B44ken/ria/hardware/oct05-mincaps/README.md

# RIA October 5 PCB candidate

Preserved assistant-authored simplified-capacitor board package, separate from the software PR. Open ria-backplane-mincaps/pcb/ria.kicad_pro in KiCad 10.

Original archive SHA256: dc820657c711623e98abf509f8b5e54f411a94344bfe15b9ce7364861eda980d.
Board SHA256: d4c210754f7143ea50357abc1c7c7ac3fd38924d02991d099fac64ac100dd1eb.

The editable schematic, board, project, libraries, available 3D models, capacitor audit, candidate status and historical DRC/ERC reports were imported from pr #5 at `72f5b655`. That original snapshot remains in git history. The subsequent [review](review-2026-10-14.md) records fresh checks and the XT60 mounting-slot correction; the hashes above identify the original archive and board.

## Limits
Historical KiCad reports describe the imported candidate. Use the review for current saved-file checks and fabrication exports. Firmware, motor-current temperatures and assembly yield remain unverified.
