B44ken/ria/hardware/oct05-mincaps/review-2026-10-14.md

# pcb review, 2026-10-14

reviewed the ss6343m candidate imported from [pr #5](https://github.com/B44ken/ria/pull/5), original head `72f5b655`. backplane now opens this project. the separate sensorless design remains in `pcb/`.

## checks

fresh kicad 10.0.6 erc, refilled drc, schematic parity and the saved-file verifier passed on the imported candidate: 69 components, 59 connected nets, zero violations, opens or exclusions. 142 independent driver pin/net assertions passed. an independent shape audit found 198 routing vias, all with 0.3mm drills and 0.6mm lands, and no via holes intersecting smd copper or paste.

## connector correction

amass's current drawing for c98732 specifies two 0.8×1.9mm mounting slots; the imported footprint used 0.6×1.6mm. the board and local footprint were corrected together, with 1.4×2.5mm copper lands preserving the original 0.3mm annulus. the top edge extends 0.15mm to retain the existing 0.5mm copper-edge clearance. connector position, pin pitch and all electrical nets remain unchanged. after these changes, fresh saved-file erc, refilled drc, parity and the updated verifier again passed with zero violations, opens or exclusions. the driver models now reference the bundled step file instead of a missing temporary path. the xt60 model preview is approximate; fit was checked against the [exact c98732 drawing](https://datasheet.lcsc.com/datasheet/pdf/e258adf1ce44622bb05a5787d35fc0fa.pdf?productCode=C98732). final checks and manufacturing hashes are in `../../build/review/pr5-72f5b65/`.

## pricing

jlcpcb quoted c$11.34 for five bare boards using the corrected 50×69.45mm fabrication files: four layers, 1.6mm thickness, green mask, hasl finish, standard drill class, free solder-mask via plugging and no paid epoxy filling/capping or plating option. this is a fabrication quote, before assembly and shipping; no order or payment was submitted.

the live assembly estimate is c$108.31 before shipping: c$11.34 for five pcbs plus c$96.97 to assemble two on the top side. it includes 68 of 69 placements per assembled board; power-u1, ap63300wu-7/c2158012, is unavailable and excluded. three boards remain bare. this is not a complete assembly quote. the assembly subtotal includes c$38.03 in parts, c$35.05 in extended-part fees and c$23.89 in setup, stencil and assembly services. quoted build time is three days for fabrication plus four to five days for assembly. source files still include the regulator; no substitution was made. [live draft](https://cart.jlcpcb.com/smt-order/?pcbFileNo=b37353e392c94e28b2f8478970549db3), screenshots and fee details are saved with the review artifacts. the driver and imu placement previews align with their footprint pin-one markers.

## qualification

checked the driver pinout and support parts against the [manufacturer v1.2 datasheet](https://www.leadpoweric.com/uploads/admin/file/20230717/f2edd0e2706f078eaf6584854d43b7dc.pdf). no electrical wiring blocker was found. continuous motor-current temperature, braking transients, firmware and assembly yield require bench verification. four encoder buses require a firmware strategy beyond the esp32-s3's two hardware i2c controllers. this board has no phase-current feedback.

final pcb sha256: `78564c2847df0ab76a1cdc7bd88127e3de6a0aa0defd4c1247653595a4438f0f`.
