B44ken/ria/build/review/pr5-72f5b65/drill-report.txt

Drill report for ria.kicad_pcb
Created on 2026-10-14T05:50:54

Copper Layer Stackup:
    =============================================================
    L1 :  F.Cu                      front
    L2 :  In1.Cu                    in1
    L3 :  In2.Cu                    in2
    L4 :  B.Cu                      back

Drill file 'ria-PTH.drl' contains
    plated through holes:
    =============================================================
    T1  0.300mm  0.0118"  (198 holes))
    T2  0.800mm  0.0315"  (4 holes)  (with 4 slots)
    T3  0.800mm  0.0315"  (2 holes)  (with 2 slots)
    T4  1.000mm  0.0394"  (16 holes))
    T5  1.700mm  0.0669"  (6 holes))
    T6  2.900mm  0.1142"  (2 holes))
    T7  4.400mm  0.1732"  (6 holes))

    Total plated holes count 234

Drill file 'ria-NPTH.drl' contains
    unplated through holes:
    =============================================================
    T1  0.600mm  0.0236"  (2 holes))

    Total unplated holes count 2
