B44ken/ria/pcb/.agents/skills/tscircuit/README.md

# tscircuit Agent Skill

This folder is intended to be used as an agent Skill.

Install as:

- `npx skills add tscircuit/skill`

The canonical entrypoint is `SKILL.md`.

## Contents

- `SKILL.md` – Main skill definition (frontmatter + instructions)
- `CLI.md` – tsci CLI command reference
- `SYNTAX.md` – tscircuit JSX syntax primer
- `WORKFLOW.md` – Recommended development workflow
- `BUS_LANES.md` – Fixed-layer bus phases, fanout handoffs, and length matching
- `CHECKLIST.md` – Pre-export/pre-fab checklist

## License

See `LICENSE` for terms.
