B44ken/ria/.playwright-mcp/page-2026-10-28T21-33-26-059Z.png

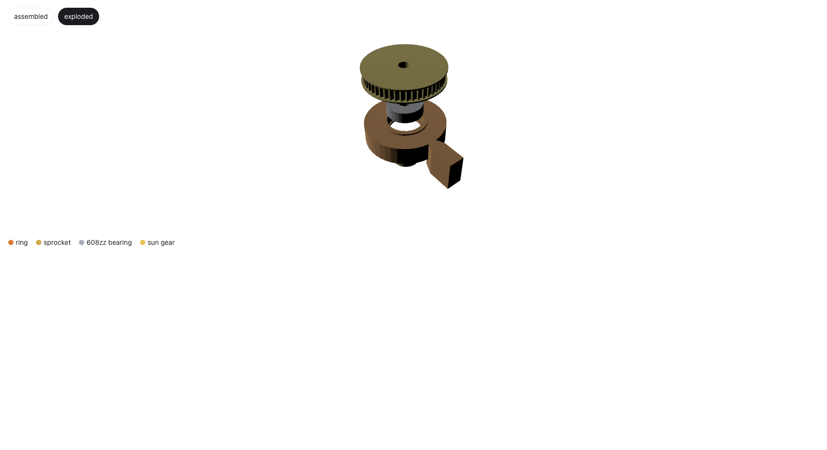
.playwright-mcp/page-2026-10-28T21-33-26-059Z.png
