B44ken/ria/.playwright-mcp/page-2026-10-28T21-34-46-661Z.png

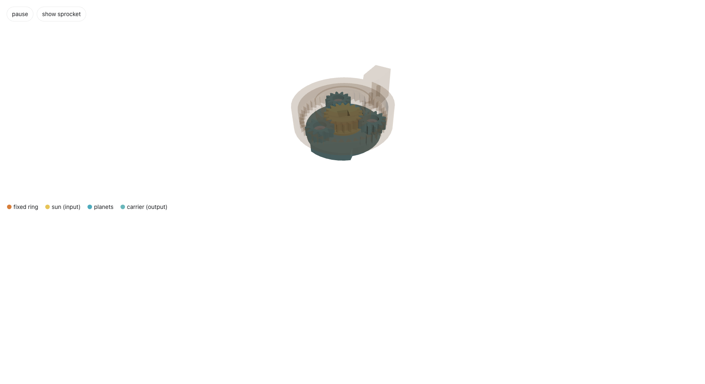
.playwright-mcp/page-2026-10-28T21-34-46-661Z.png
