B44ken/ria/.playwright-mcp/page-2026-10-28T21-44-37-201Z.png

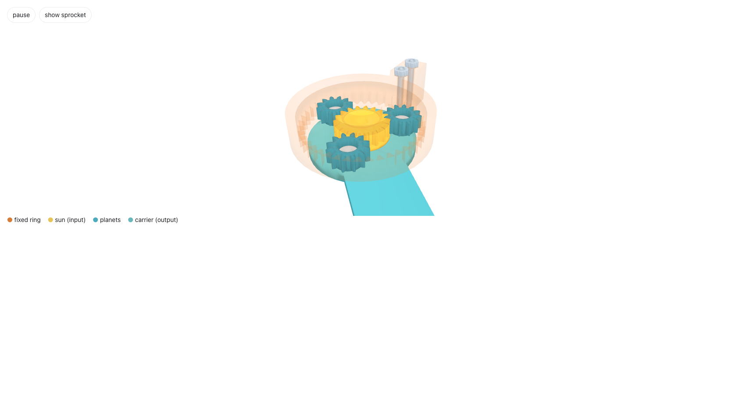
.playwright-mcp/page-2026-10-28T21-44-37-201Z.png
