B44ken/ria/.playwright-mcp/page-2026-10-28T21-49-19-035Z.png

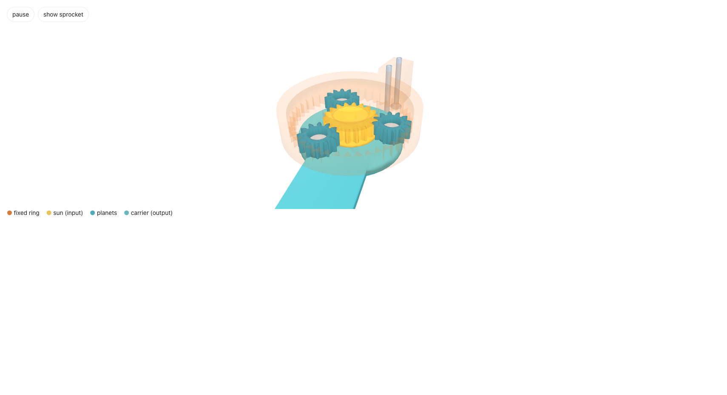
.playwright-mcp/page-2026-10-28T21-49-19-035Z.png
