B44ken/ria/build/pcb-review/schematic.png

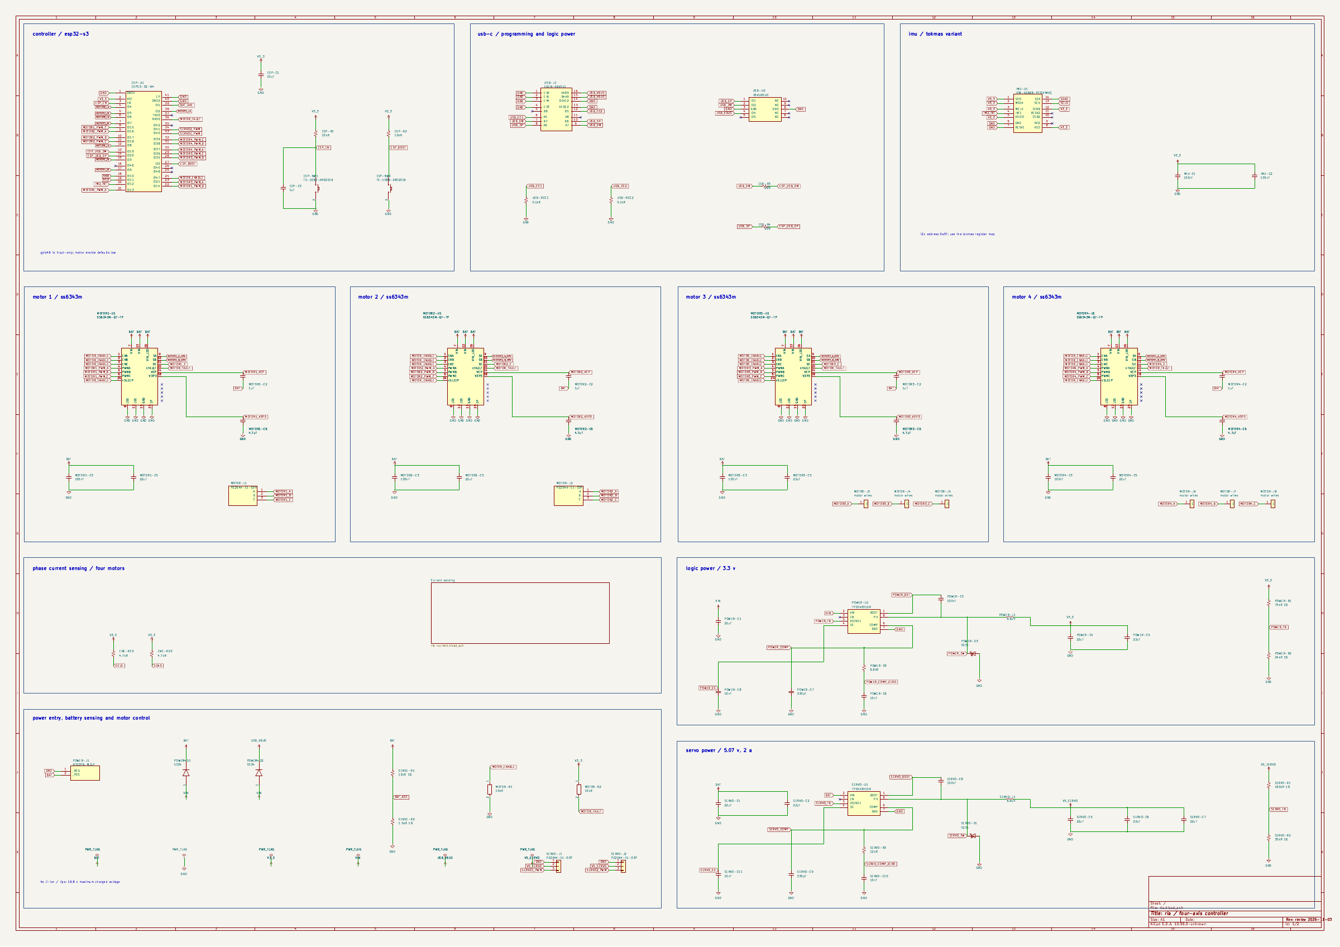
build/pcb-review/schematic.png
