B44ken/ria/build/pcb-review/bom.csv

Comment | Designator | Footprint | LCSC Part # | MPN | Manufacturer
4.7kR | ENC-RC0 | ria:ENC-RC0 | C23162 | 0603WAF4701T5E | UNI-ROYAL(Uniroyal Elec)
4.7kR | ENC-RD0 | ria:ENC-RD0 | C23162 | 0603WAF4701T5E | UNI-ROYAL(Uniroyal Elec)
10uF | ESP-C1 | ria:ESP-C1 | C15850 | CL21A106KAYNNNE | Samsung Electro-Mechanics
1uF | ESP-C3 | ria:C_0805_2012Metric | C28323 | CL21B105KBFNNNE | Samsung Electro-Mechanics
10kR | ESP-R1 | ria:ESP-R1 | C25804 | 0603WAF1002T5E | UNI-ROYAL(Uniroyal Elec)
10kR | ESP-R2 | ria:ESP-R2 | C25804 | 0603WAF1002T5E | UNI-ROYAL(Uniroyal Elec)
22R | ESP-R3 | ria:ESP-R3 | C23345 | 0603WAF220JT5E | UNI-ROYAL(Uniroyal Elec)
22R | ESP-R4 | ria:ESP-R4 | C23345 | 0603WAF220JT5E | UNI-ROYAL(Uniroyal Elec)
TS-1088-AR02016 | ESP-SW1 | ria:ESP-SW1 | C720477 | TS-1088-AR02016 | XUNPU
TS-1088-AR02016 | ESP-SW2 | ria:ESP-SW2 | C720477 | TS-1088-AR02016 | XUNPU
ESPS3-32-N4 | ESP-U1 | ria:ESP-U1 | C49164655 | ESPS3-32-N4 | DOIT
100nF | IMU-C1 | ria:IMU-C1 | C14663 | CC0603KRX7R9BB104 | YAGEO
100nF | IMU-C2 | ria:IMU-C2 | C14663 | CC0603KRX7R9BB104 | YAGEO
ICM-42688-P(TOKMAS) | IMU-U1 | ria:IMU-U1 | C54308212 | ICM-42688-P(TOKMAS) | Tokmas
PZ254V-11-03P | MOTOR-J1 | ria:MOTOR-J1 | C2937625 | PZ254V-11-03P | XFCN
PZ254V-11-03P | MOTOR-J2 | ria:MOTOR-J2 | C2937625 | PZ254V-11-03P | XFCN
10kR | MOTOR-R1 | ria:MOTOR-RE | C25804 | 0603WAF1002T5E | UNI-ROYAL(Uniroyal Elec)
10kR | MOTOR-R2 | ria:MOTOR-RS | C25804 | 0603WAF1002T5E | UNI-ROYAL(Uniroyal Elec)
1uF | MOTOR1-C2 | ria:C_0805_2012Metric | C28323 | CL21B105KBFNNNE | Samsung Electro-Mechanics
100nF | MOTOR1-C3 | ria:MOTOR1-C3 | C14663 | CC0603KRX7R9BB104 | YAGEO
22uF | MOTOR1-C5 | ria:C_1206_3216Metric | C12891 | CL31A226KAHNNNE | Samsung Electro-Mechanics
4.7uF | MOTOR1-C6 | ria:MOTOR1-C6 | C19666 | CL10A475KO8NNNC | Samsung Electro-Mechanics
100nF | MOTOR1-CC1 | ria:C_0603_CURRENT | C14663 | CC0603KRX7R9BB104 | YAGEO
100nF | MOTOR1-CC2 | ria:C_0603_CURRENT | C14663 | CC0603KRX7R9BB104 | YAGEO
INA241A3IDDFR | MOTOR1-CS1 | ria:INA241A3_DDF | C6051860 | INA241A3IDDFR | Texas Instruments
INA241A3IDDFR | MOTOR1-CS2 | ria:INA241A3_DDF | C6051860 | INA241A3IDDFR | Texas Instruments
10mOhm 1% 1W | MOTOR1-RS1 | ria:SHUNT_1206_KELVIN | C2692042 | SMR12M1FR010T | SART
10mOhm 1% 1W | MOTOR1-RS2 | ria:SHUNT_1206_KELVIN | C2692042 | SMR12M1FR010T | SART
SS6343M-QF-TP | MOTOR1-U1 | ria:SS6343M-QF-TP | C5370899 | SS6343M-QF-TP | LEADPOWER
1uF | MOTOR2-C2 | ria:C_0805_2012Metric | C28323 | CL21B105KBFNNNE | Samsung Electro-Mechanics
100nF | MOTOR2-C3 | ria:MOTOR2-C3 | C14663 | CC0603KRX7R9BB104 | YAGEO
22uF | MOTOR2-C5 | ria:C_1206_3216Metric | C12891 | CL31A226KAHNNNE | Samsung Electro-Mechanics
4.7uF | MOTOR2-C6 | ria:MOTOR2-C6 | C19666 | CL10A475KO8NNNC | Samsung Electro-Mechanics
100nF | MOTOR2-CC1 | ria:C_0603_CURRENT | C14663 | CC0603KRX7R9BB104 | YAGEO
100nF | MOTOR2-CC2 | ria:C_0603_CURRENT | C14663 | CC0603KRX7R9BB104 | YAGEO
INA241A3IDDFR | MOTOR2-CS1 | ria:INA241A3_DDF | C6051860 | INA241A3IDDFR | Texas Instruments
INA241A3IDDFR | MOTOR2-CS2 | ria:INA241A3_DDF | C6051860 | INA241A3IDDFR | Texas Instruments
10mOhm 1% 1W | MOTOR2-RS1 | ria:SHUNT_1206_KELVIN | C2692042 | SMR12M1FR010T | SART
10mOhm 1% 1W | MOTOR2-RS2 | ria:SHUNT_1206_KELVIN | C2692042 | SMR12M1FR010T | SART
SS6343M-QF-TP | MOTOR2-U1 | ria:SS6343M-QF-TP | C5370899 | SS6343M-QF-TP | LEADPOWER
1uF | MOTOR3-C2 | ria:C_0805_2012Metric | C28323 | CL21B105KBFNNNE | Samsung Electro-Mechanics
100nF | MOTOR3-C3 | ria:MOTOR3-C3 | C14663 | CC0603KRX7R9BB104 | YAGEO
22uF | MOTOR3-C5 | ria:C_1206_3216Metric | C12891 | CL31A226KAHNNNE | Samsung Electro-Mechanics
4.7uF | MOTOR3-C6 | ria:MOTOR3-C6 | C19666 | CL10A475KO8NNNC | Samsung Electro-Mechanics
100nF | MOTOR3-CC1 | ria:C_0603_CURRENT | C14663 | CC0603KRX7R9BB104 | YAGEO
100nF | MOTOR3-CC2 | ria:C_0603_CURRENT | C14663 | CC0603KRX7R9BB104 | YAGEO
INA241A3IDDFR | MOTOR3-CS1 | ria:INA241A3_DDF | C6051860 | INA241A3IDDFR | Texas Instruments
INA241A3IDDFR | MOTOR3-CS2 | ria:INA241A3_DDF | C6051860 | INA241A3IDDFR | Texas Instruments
10mOhm 1% 1W | MOTOR3-RS1 | ria:SHUNT_1206_KELVIN | C2692042 | SMR12M1FR010T | SART
10mOhm 1% 1W | MOTOR3-RS2 | ria:SHUNT_1206_KELVIN | C2692042 | SMR12M1FR010T | SART
SS6343M-QF-TP | MOTOR3-U1 | ria:SS6343M-QF-TP | C5370899 | SS6343M-QF-TP | LEADPOWER
1uF | MOTOR4-C2 | ria:C_0805_2012Metric | C28323 | CL21B105KBFNNNE | Samsung Electro-Mechanics
100nF | MOTOR4-C3 | ria:MOTOR4-C3 | C14663 | CC0603KRX7R9BB104 | YAGEO
22uF | MOTOR4-C5 | ria:C_1206_3216Metric | C12891 | CL31A226KAHNNNE | Samsung Electro-Mechanics
4.7uF | MOTOR4-C6 | ria:MOTOR4-C6 | C19666 | CL10A475KO8NNNC | Samsung Electro-Mechanics
100nF | MOTOR4-CC1 | ria:C_0603_CURRENT | C14663 | CC0603KRX7R9BB104 | YAGEO
100nF | MOTOR4-CC2 | ria:C_0603_CURRENT | C14663 | CC0603KRX7R9BB104 | YAGEO
INA241A3IDDFR | MOTOR4-CS1 | ria:INA241A3_DDF | C6051860 | INA241A3IDDFR | Texas Instruments
INA241A3IDDFR | MOTOR4-CS2 | ria:INA241A3_DDF | C6051860 | INA241A3IDDFR | Texas Instruments
10mOhm 1% 1W | MOTOR4-RS1 | ria:SHUNT_1206_KELVIN | C2692042 | SMR12M1FR010T | SART
10mOhm 1% 1W | MOTOR4-RS2 | ria:SHUNT_1206_KELVIN | C2692042 | SMR12M1FR010T | SART
SS6343M-QF-TP | MOTOR4-U1 | ria:SS6343M-QF-TP | C5370899 | SS6343M-QF-TP | LEADPOWER
22uF | POWER-C1 | ria:POWER-C1 | C12891 | CL31A226KAHNNNE | Samsung Electro-Mechanics
100nF | POWER-C3 | ria:POWER-C3 | C14663 | CC0603KRX7R9BB104 | YAGEO
22uF | POWER-C4 | ria:POWER-C4 | C12891 | CL31A226KAHNNNE | Samsung Electro-Mechanics
22uF | POWER-C5 | ria:POWER-C5 | C12891 | CL31A226KAHNNNE | Samsung Electro-Mechanics
10nF | POWER-C6 | ria:POWER-C6 | C57112 | 0603B103K500NT | FH (Guangdong Fenghua Advanced Tech)
330pF | POWER-C7 | ria:POWER-C7 | C1664 | CL10C331JB8NNNC | Samsung Electro-Mechanics
10nF | POWER-C8 | ria:POWER-C8 | C57112 | 0603B103K500NT | FH (Guangdong Fenghua Advanced Tech)
SS34 | POWER-D1 | ria:POWER-D1 | C8678 | SS34 | MDD(Microdiode Semiconductor)
SS34 | POWER-D2 | ria:POWER-D2 | C8678 | SS34 | MDD(Microdiode Semiconductor)
SS34 | POWER-D3 | ria:POWER-D3 | C8678 | SS34 | MDD
XT60PB-M.G.Y | POWER-J1 | ria:POWER-J1 | C19268037 | XT60PB-M.G.Y | Changzhou Amass Elec
6.8uH | POWER-L1 | ria:POWER-L1 | C168072 | FNR6045S6R8MT | cjiang
75kR 1% | POWER-R1 | ria:POWER-R1 | C23242 | 0603WAF7502T5E | UNI-ROYAL(Uniroyal Elec)
24kR 1% | POWER-R2 | ria:POWER-R2 | C23352 | 0603WAF2402T5E | UNI-ROYAL(Uniroyal Elec)
6.8kR | POWER-R3 | ria:POWER-R3 | C23212 | 0603WAF6801T5E | UNI-ROYAL
TPS54331DR | POWER-U1 | ria:POWER-U1 | C9865 | TPS54331DR | Texas Instruments
10kR 1% | SENSE-R1 | ria:SENSE-R1 | C25804 | 0603WAF1002T5E | UNI-ROYAL
1.5kR 1% | SENSE-R2 | ria:SENSE-R2 | C22843 | 0603WAF1501T5E | UNI-ROYAL
22uF | SERVO-C1 | ria:SERVO-C1 | C12891 | CL31A226KAHNNNE | Samsung Electro-Mechanics
22uF | SERVO-C2 | ria:SERVO-C2 | C12891 | CL31A226KAHNNNE | Samsung Electro-Mechanics
22uF | SERVO-C5 | ria:SERVO-C5 | C12891 | CL31A226KAHNNNE | Samsung Electro-Mechanics
22uF | SERVO-C6 | ria:SERVO-C6 | C12891 | CL31A226KAHNNNE | Samsung Electro-Mechanics
22uF | SERVO-C7 | ria:SERVO-C7 | C12891 | CL31A226KAHNNNE | Samsung Electro-Mechanics
100nF | SERVO-C8 | ria:SERVO-C8 | C14663 | CC0603KRX7R9BB104 | YAGEO
330pF | SERVO-C9 | ria:SERVO-C9 | C1664 | CL10C331JB8NNNC | Samsung Electro-Mechanics
10nF | SERVO-C10 | ria:SERVO-C10 | C57112 | 0603B103K500NT | FH (Guangdong Fenghua Advanced Tech)
10nF | SERVO-C11 | ria:SERVO-C11 | C57112 | 0603B103K500NT | FH (Guangdong Fenghua Advanced Tech)
SS34 | SERVO-D1 | ria:SERVO-D1 | C8678 | SS34 | MDD
PZ254V-11-03P | SERVO-J1 | ria:SERVO-J1 | C2937625 | PZ254V-11-03P | XFCN
PZ254V-11-03P | SERVO-J2 | ria:SERVO-J2 | C2937625 | PZ254V-11-03P | XFCN
6.8uH | SERVO-L1 | ria:SERVO-L1 | C168072 | FNR6045S6R8MT | cjiang
160kR 1% | SERVO-R1 | ria:SERVO-R1 | C22813 | 0603WAF1603T5E | UNI-ROYAL(Uniroyal Elec)
30kR 1% | SERVO-R2 | ria:SERVO-R2 | C22984 | 0603WAF3002T5E | UNI-ROYAL(Uniroyal Elec)
12kR | SERVO-R3 | ria:SERVO-R3 | C22790 | 0603WAF1202T5E | UNI-ROYAL
TPS54331DR | SERVO-U1 | ria:SERVO-U1 | C9865 | TPS54331DR | Texas Instruments
161N-4BVS11 | USB-J1 | ria:USB-J1 | C5440752 | 161N-4BVS11 | HanElectricity
5.1kR | USB-RCC1 | ria:USB-RCC1 | C23186 | 0603WAF5101T5E | UNI-ROYAL(Uniroyal Elec)
5.1kR | USB-RCC2 | ria:USB-RCC2 | C23186 | 0603WAF5101T5E | UNI-ROYAL(Uniroyal Elec)
H5VU25UC | USB-U2 | ria:USB-U2 | C20615800 | H5VU25UC | Zhuhai Hongjiacheng Technology
