B44ken/ria/pcb/fab/jlc-bom.csv

Comment | Designator | Footprint | LCSC Part #
ENC-J1 | ENC-J1 | ria:ENC-J1 | C2691448
ENC-J2 | ENC-J2 | ria:ENC-J2 | C2691448
ENC-J3 | ENC-J3 | ria:ENC-J3 | C2691448
ENC-J4 | ENC-J4 | ria:ENC-J4 | C2691448
4.7kΩ | ENC-RC0 | ria:ENC-RC0 | C23162
4.7kΩ | ENC-RC1 | ria:ENC-RC1 | C23162
4.7kΩ | ENC-RC2 | ria:ENC-RC2 | C23162
4.7kΩ | ENC-RC3 | ria:ENC-RC3 | C23162
4.7kΩ | ENC-RD0 | ria:ENC-RD0 | C23162
4.7kΩ | ENC-RD1 | ria:ENC-RD1 | C23162
4.7kΩ | ENC-RD2 | ria:ENC-RD2 | C23162
4.7kΩ | ENC-RD3 | ria:ENC-RD3 | C23162
10uF | ESP-C1 | ria:ESP-C1 | C15850
1uF | ESP-C3 | ria:C_0805_2012Metric | C28323
10kΩ | ESP-R1 | ria:ESP-R1 | C25804
10kΩ | ESP-R2 | ria:ESP-R2 | C25804
22Ω | ESP-R3 | ria:ESP-R3 | C23345
22Ω | ESP-R4 | ria:ESP-R4 | C23345
ESP-SW1 | ESP-SW1 | ria:ESP-SW1 | C720477
ESP-SW2 | ESP-SW2 | ria:ESP-SW2 | C720477
ESPS3-32-N4 | ESP-U1 | ria:ESP-U1 | C49164655
100nF | IMU-C1 | ria:IMU-C1 | C14663
100nF | IMU-C2 | ria:IMU-C2 | C14663
ICM-42688-P(TOKMAS) | IMU-U1 | ria:IMU-U1 | C54308212
WJ2EDGR-5.08-03P-14-00A | MOTOR-J1 | ria:WJ2EDGR-5.08-03P-14-00A | C70914
WJ2EDGR-5.08-03P-14-00A | MOTOR-J2 | ria:WJ2EDGR-5.08-03P-14-00A | C70914
GC3510-F | MOTOR-J3 | ria:MOTOR-J3A | C964714
GC3510-F | MOTOR-J4 | ria:MOTOR-J3B | C964714
GC3510-F | MOTOR-J5 | ria:MOTOR-J3C | C964714
GC3510-F | MOTOR-J6 | ria:MOTOR-J4A | C964714
GC3510-F | MOTOR-J7 | ria:MOTOR-J4B | C964714
GC3510-F | MOTOR-J8 | ria:MOTOR-J4C | C964714
10kΩ | MOTOR-R1 | ria:MOTOR-RE | C25804
10kΩ | MOTOR-R2 | ria:MOTOR-RS | C25804
1uF | MOTOR1-C2 | ria:C_0805_2012Metric | C28323
100nF | MOTOR1-C3 | ria:MOTOR1-C3 | C14663
22uF | MOTOR1-C5 | ria:C_1206_3216Metric | C12891
4.7uF | MOTOR1-C6 | ria:MOTOR1-C6 | C19666
SS6343M-QF-TP | MOTOR1-U1 | ria:SS6343M-QF-TP | C5370899
1uF | MOTOR2-C2 | ria:C_0805_2012Metric | C28323
100nF | MOTOR2-C3 | ria:MOTOR2-C3 | C14663
22uF | MOTOR2-C5 | ria:C_1206_3216Metric | C12891
4.7uF | MOTOR2-C6 | ria:MOTOR2-C6 | C19666
SS6343M-QF-TP | MOTOR2-U1 | ria:SS6343M-QF-TP | C5370899
1uF | MOTOR3-C2 | ria:C_0805_2012Metric | C28323
100nF | MOTOR3-C3 | ria:MOTOR3-C3 | C14663
22uF | MOTOR3-C5 | ria:C_1206_3216Metric | C12891
4.7uF | MOTOR3-C6 | ria:MOTOR3-C6 | C19666
SS6343M-QF-TP | MOTOR3-U1 | ria:SS6343M-QF-TP | C5370899
1uF | MOTOR4-C2 | ria:C_0805_2012Metric | C28323
100nF | MOTOR4-C3 | ria:MOTOR4-C3 | C14663
22uF | MOTOR4-C5 | ria:C_1206_3216Metric | C12891
4.7uF | MOTOR4-C6 | ria:MOTOR4-C6 | C19666
SS6343M-QF-TP | MOTOR4-U1 | ria:SS6343M-QF-TP | C5370899
22uF | POWER-C1 | ria:POWER-C1 | C12891
100nF | POWER-C3 | ria:POWER-C3 | C14663
22uF | POWER-C4 | ria:POWER-C4 | C12891
22uF | POWER-C5 | ria:POWER-C5 | C12891
SS34 | POWER-D1 | ria:POWER-D1 | C8678
SS34 | POWER-D2 | ria:POWER-D2 | C8678
XT60PW-M | POWER-J1 | ria:POWER-J1 | C98732
4.7µH | POWER-L1 | ria:POWER-L1 | C167963
75kΩ | POWER-R1 | ria:POWER-R1 | C23242
24kΩ | POWER-R2 | ria:POWER-R2 | C23352
AP63301WU-7 | POWER-U1 | ria:POWER-U1 | C2158003
TYPE-C-31-M-12 | USB-J1 | ria:USB-J1 | C165948
5.1kΩ | USB-RCC1 | ria:USB-RCC1 | C23186
5.1kΩ | USB-RCC2 | ria:USB-RCC2 | C23186
USBLC6-2SC6 | USB-U2 | ria:USB-U2 | C2687116
