B44ken/ria/build/stl/head_top.stl

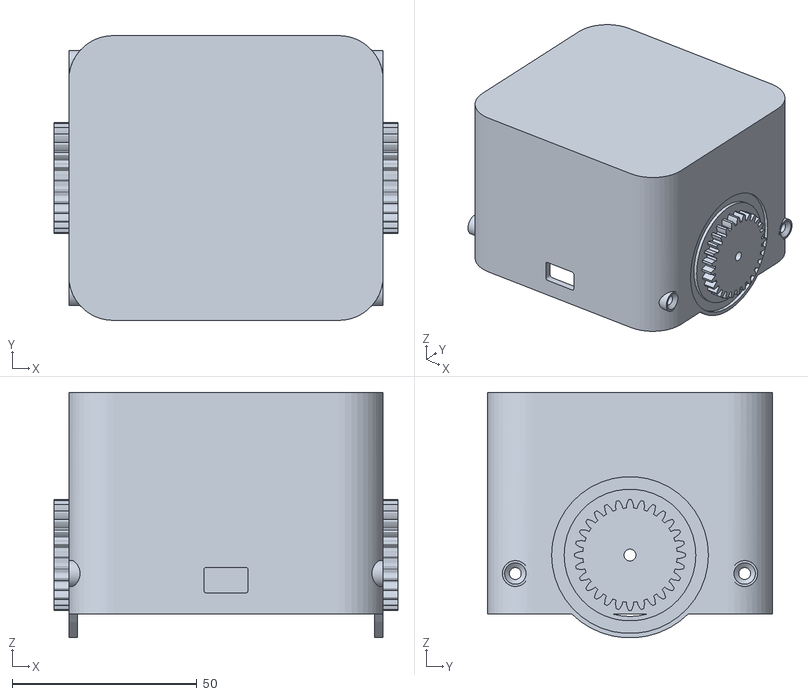
[picture p8: CAD file, 2026-11-03]
build/stl/head_top.stl
93.0 x 77.0 x 66.3
