B44ken/ria/build/stl/ring.stl

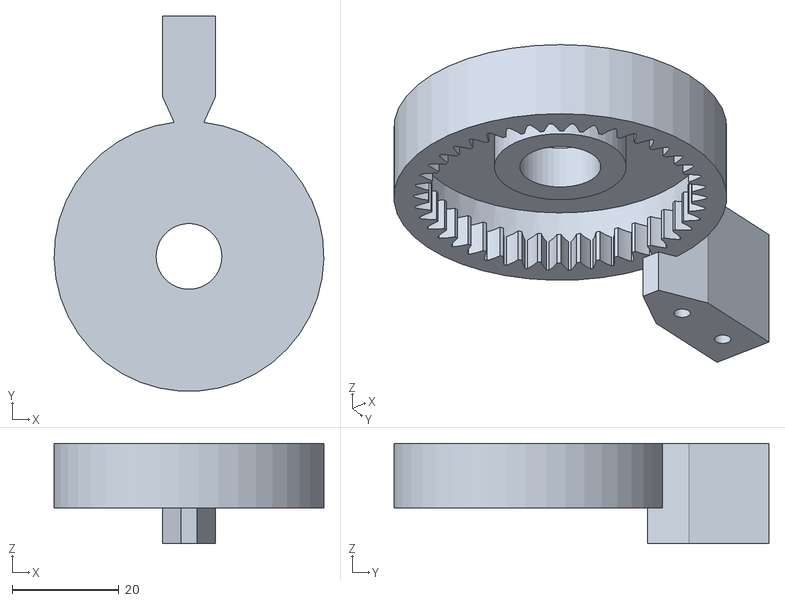
[picture p9: CAD file, 2026-11-03]
build/stl/ring.stl
50.5 x 70.2 x 18.8
