B44ken/ria/build/stl/sprocket_upper.stl

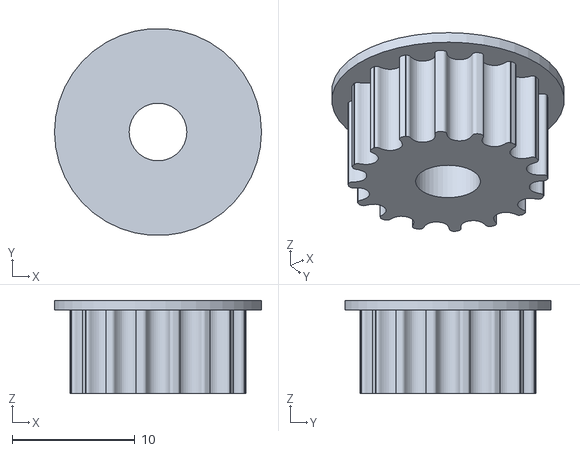
[picture p10: CAD file, 2026-11-03]
build/stl/sprocket_upper.stl
16.9 x 16.8 x 7.60
