B44ken/ria/build/stl/upper_leg.stl

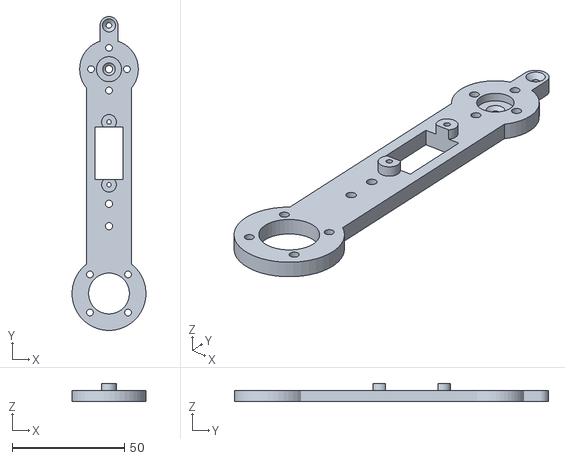
[picture p11: CAD file, 2026-11-03]
build/stl/upper_leg.stl
33.0 x 140.0 x 8.20
