B44ken/ria/build/stl/head_bottom.stl

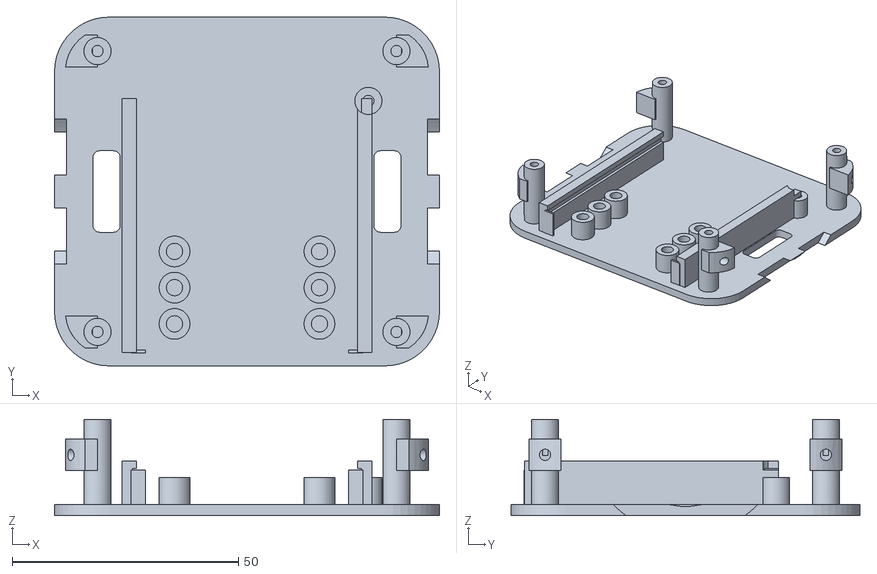
[picture p12: CAD file, 2026-11-03]
build/stl/head_bottom.stl
85.0 x 77.0 x 21.2
