B44ken/ria/build/stl/head_tray.stl

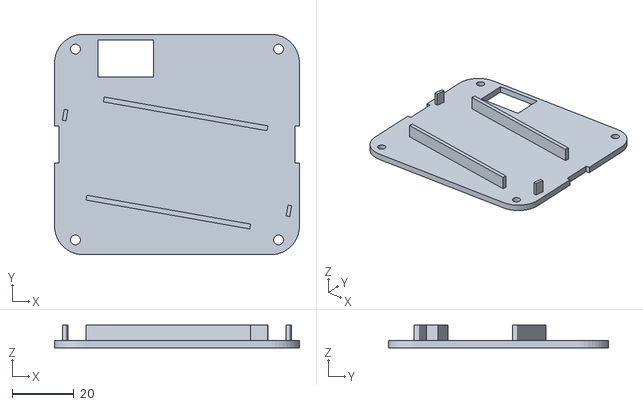
[picture p13: CAD file, 2026-11-03]
build/stl/head_tray.stl
79.6 x 71.6 x 7.40
