B44ken/ria/build/stl/wheel.stl

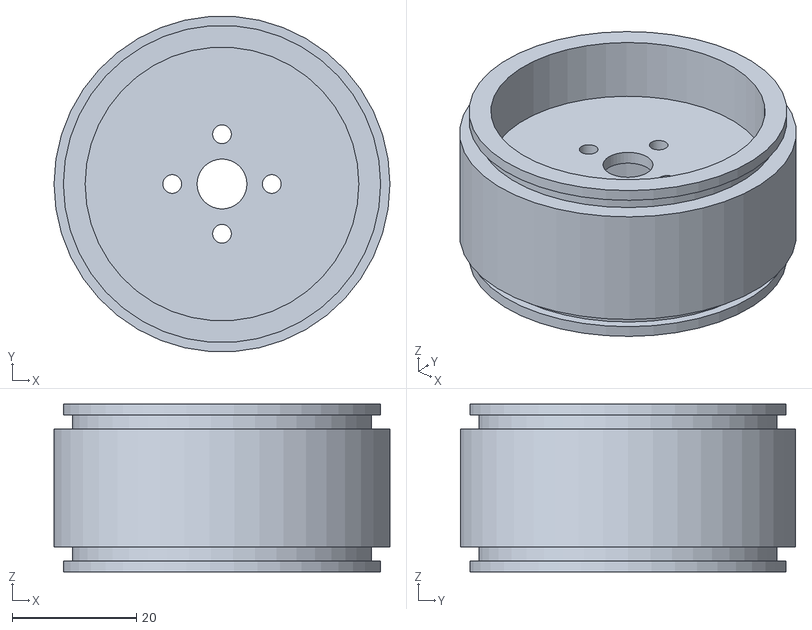
[picture p14: CAD file, 2026-10-20]
build/stl/wheel.stl
54.0 x 53.8 x 27.0
