B44ken/ria/build/stl/planet_0.stl

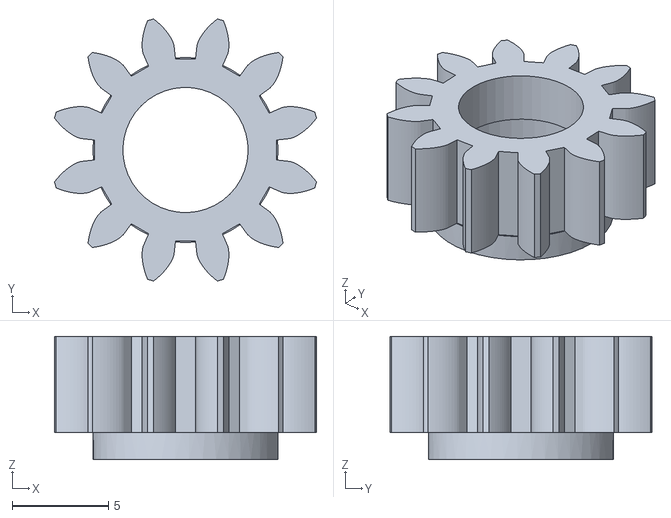
[picture p15: CAD file, 2026-10-20]
build/stl/planet_0.stl
13.6 x 13.6 x 6.40
