B44ken/ria/build/stl/planet_bearing_1.stl

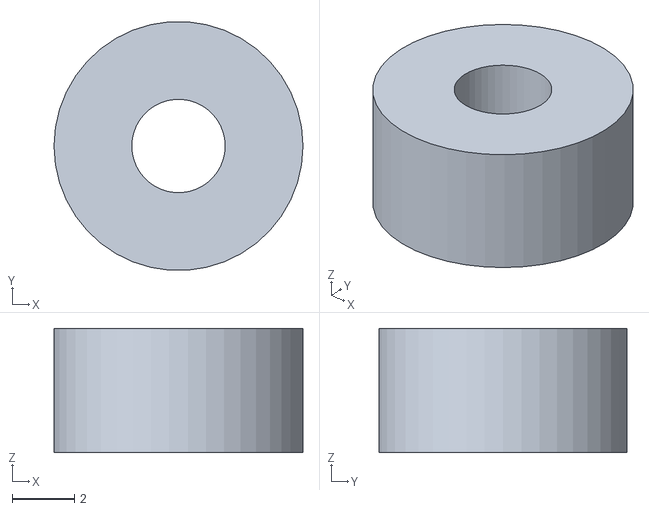
[picture p16: CAD file, 2026-10-20]
build/stl/planet_bearing_1.stl
8.00 x 7.98 x 4.00
