B44ken/ria/build/stl/magnet_ankle.stl

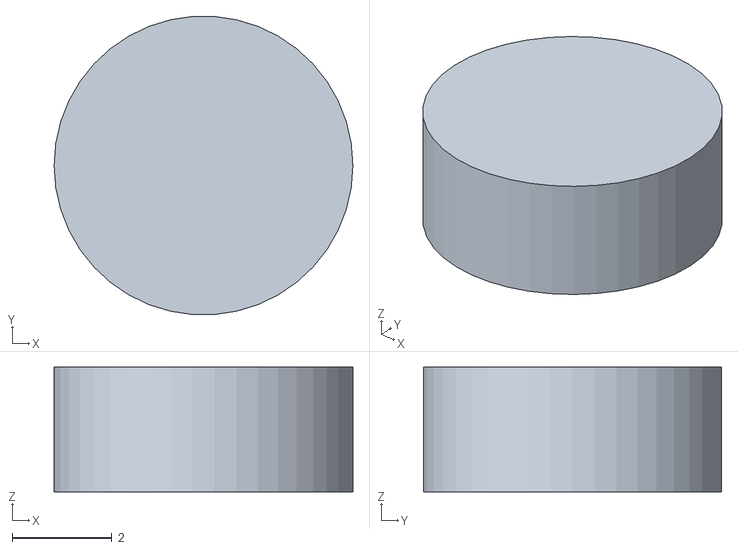
[picture p17: CAD file, 2026-10-20]
build/stl/magnet_ankle.stl
6.00 x 5.98 x 2.50
