B44ken/ria/build/stl/lower_leg.stl

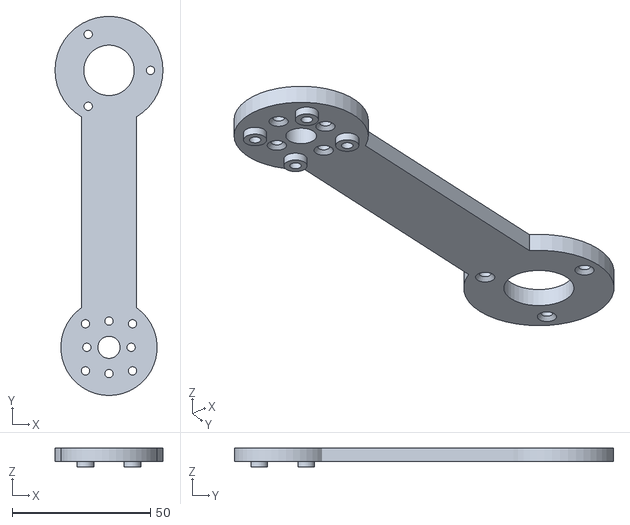
[picture p18: CAD file, 2026-10-20]
build/stl/lower_leg.stl
39.0 x 136.8 x 6.85
