B44ken/ria/build/stl/tire.stl

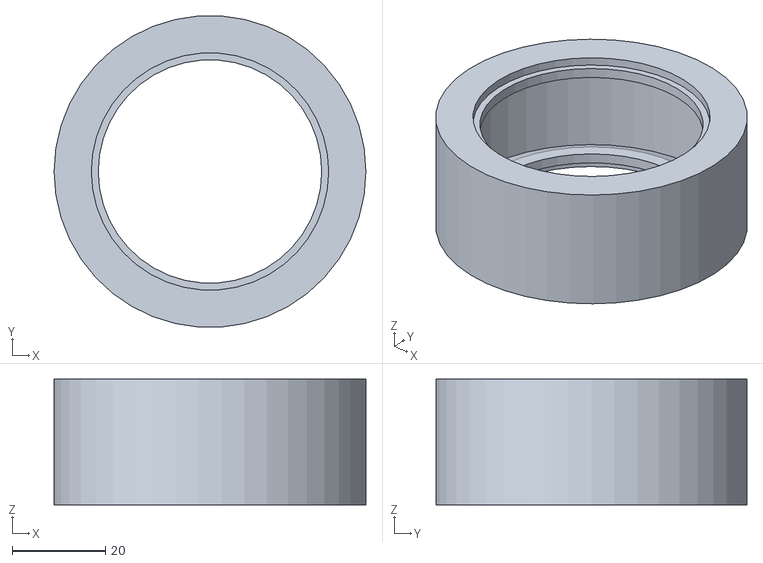
[picture p19: CAD file, 2026-10-20]
build/stl/tire.stl
67.0 x 66.8 x 27.0
