B44ken/ria/build/stl/hip_follower.stl

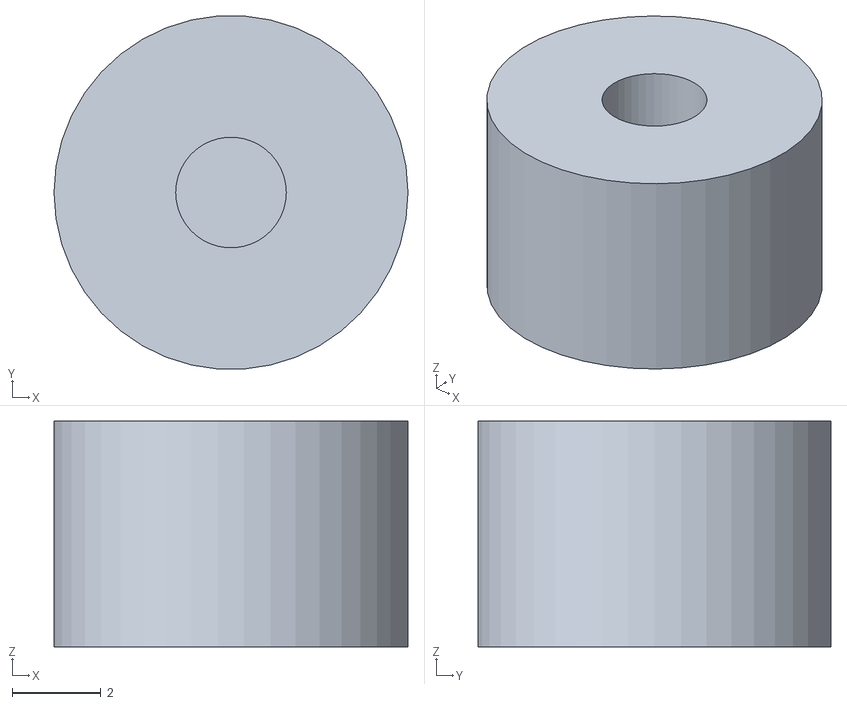
[picture p20: CAD file, 2026-10-05]
build/stl/hip_follower.stl
8.00 x 7.98 x 5.10
