B44ken/ria/build/stl/pulley.stl

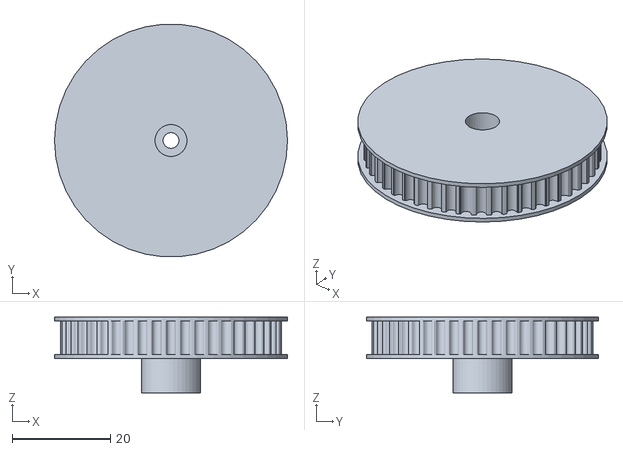
[picture p21: CAD file, 2026-10-05]
build/stl/pulley.stl
47.4 x 47.3 x 15.4
