B44ken/ria/build/stl/pinion.stl

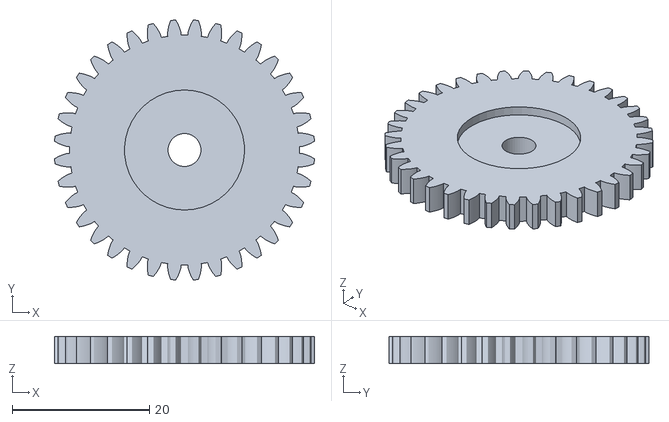
[picture p22: CAD file, 2026-10-05]
build/stl/pinion.stl
37.9 x 37.9 x 4.00
