B44ken/ria/build/stl/belt.stl

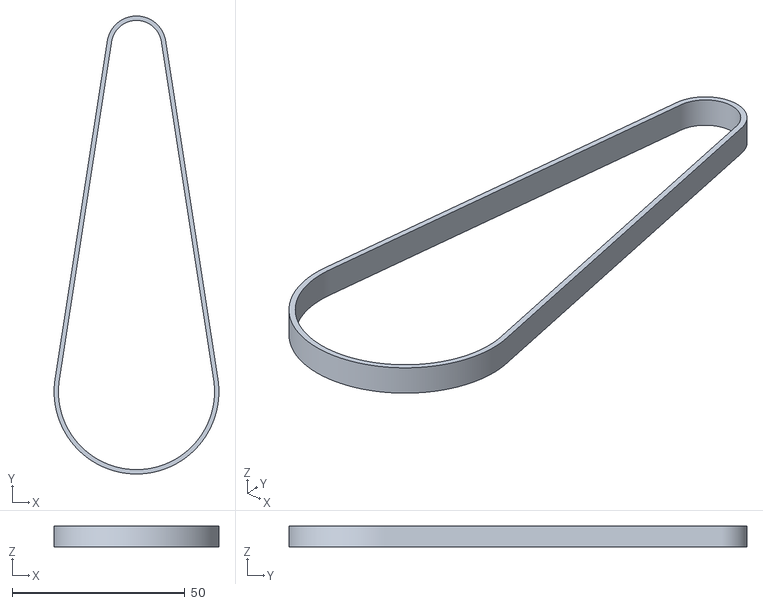
[picture p23: CAD file, 2026-10-05]
build/stl/belt.stl
47.7 x 132.4 x 6.00
