B44ken/ria/build/stl/sun.stl

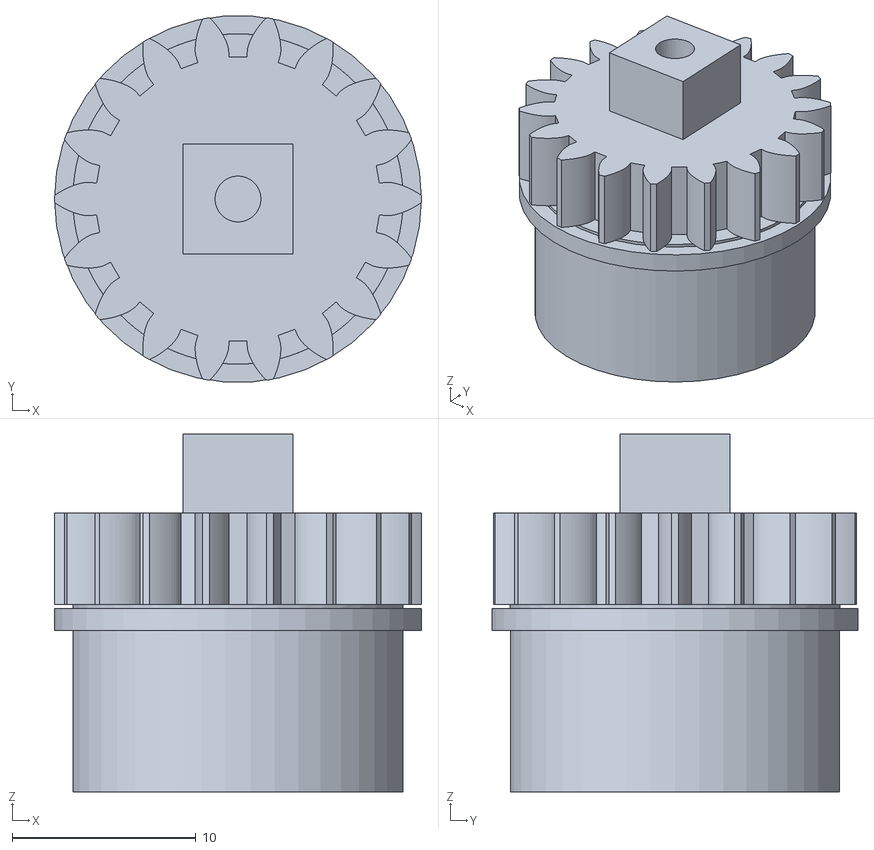
[picture p24: CAD file, 2026-10-05]
build/stl/sun.stl
20.0 x 19.9 x 19.5
