B44ken/ria/build/stl/gbm2804_3.stl

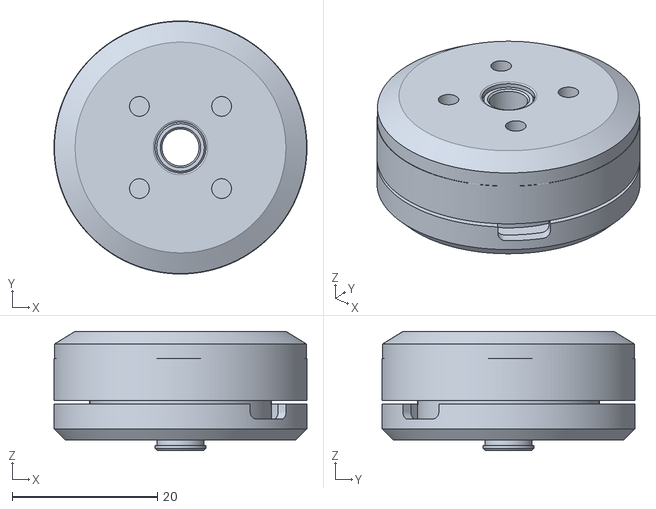
[picture p25: CAD file, 2026-09-28]
build/stl/gbm2804_3.stl
34.8 x 34.8 x 16.5
