B44ken/ria/build/stl/as5600_5.stl

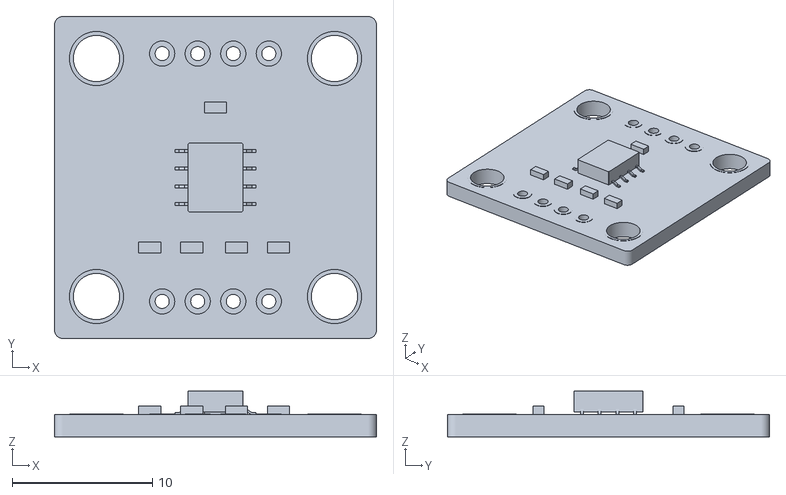
[picture p26: CAD file, 2026-09-28]
build/stl/as5600_5.stl
23.0 x 23.0 x 3.25
