B44ken/ria/build/stl/mp1584_3.stl

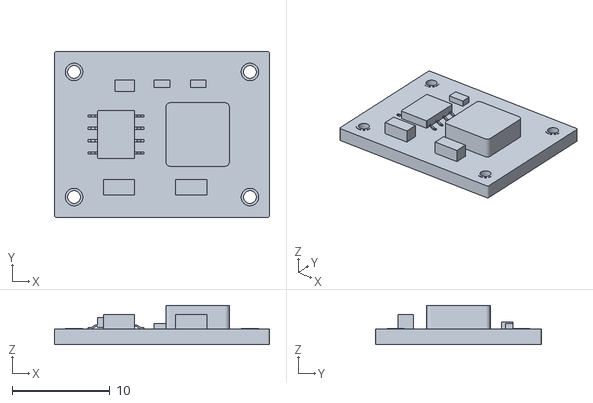
[picture p27: CAD file, 2026-09-28]
build/stl/mp1584_3.stl
22.0 x 17.0 x 4.00
