B44ken/ria/build/stl/5010_rotor_1.stl

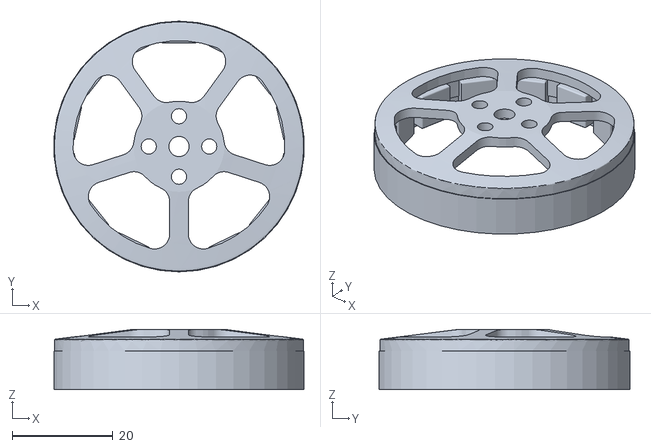
[picture p28: CAD file, 2026-09-28]
build/stl/5010_rotor_1.stl
49.6 x 49.8 x 12.0
