B44ken/ria/build/stl/tca9548a_2.stl

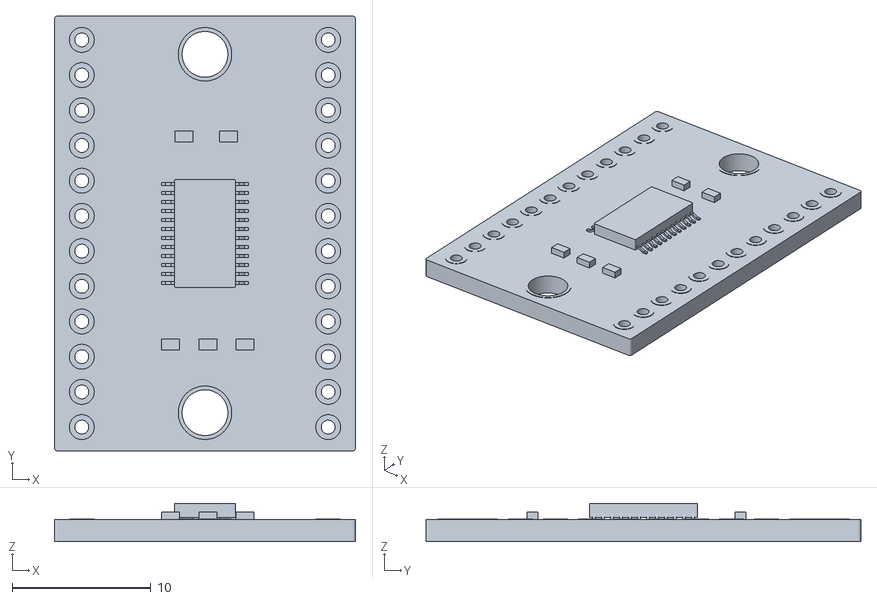
[picture p29: CAD file, 2026-09-28]
build/stl/tca9548a_2.stl
21.7 x 31.4 x 2.75
