B44ken/ria/build/stl/xt60h_m_4.stl

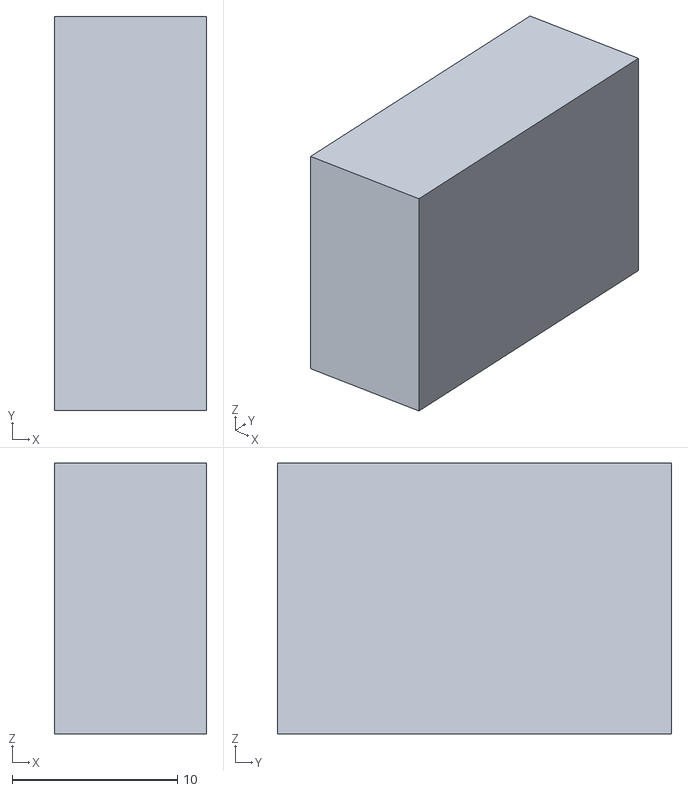
[picture p30: CAD file, 2026-09-28]
build/stl/xt60h_m_4.stl
9.20 x 23.8 x 16.4
