B44ken/ria/build/stl/tray_spacer_3.stl

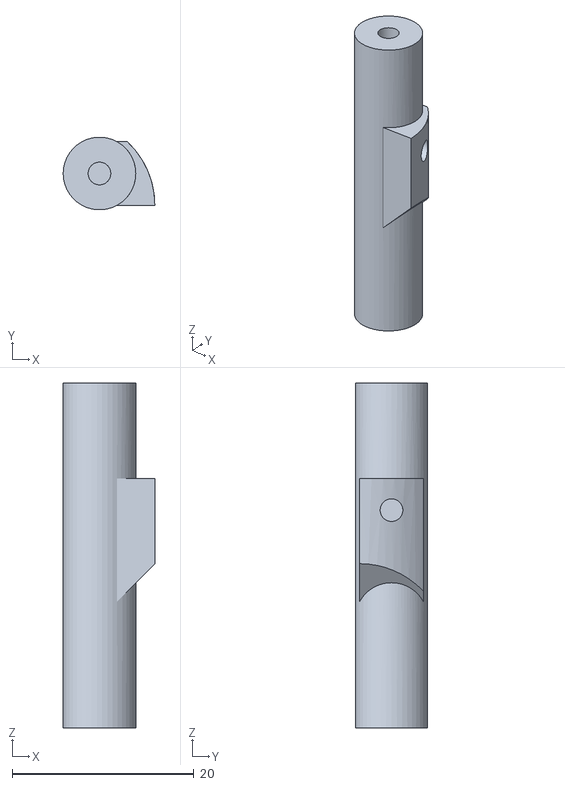
[picture p31: CAD file, 2026-09-28]
build/stl/tray_spacer_3.stl
10.1 x 7.98 x 38.0
