B44ken/ria/build/stl/5010_body_0.stl

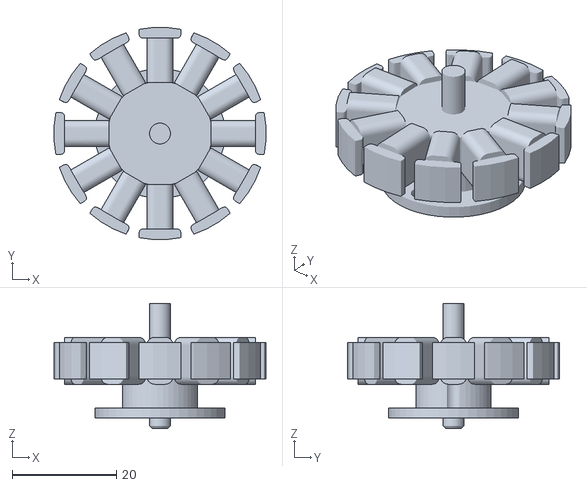
[picture p32: CAD file, 2026-09-28]
build/stl/5010_body_0.stl
40.6 x 40.6 x 24.0
