B44ken/ria/build/stl/sg90_body_2.stl

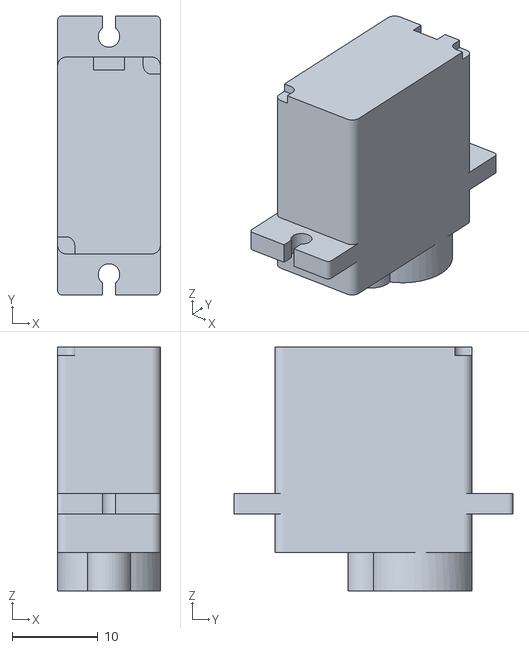
[picture p33: CAD file, 2026-09-28]
build/stl/sg90_body_2.stl
12.0 x 32.6 x 28.5
