B44ken/ria/build/stl/mpu6050_7.stl

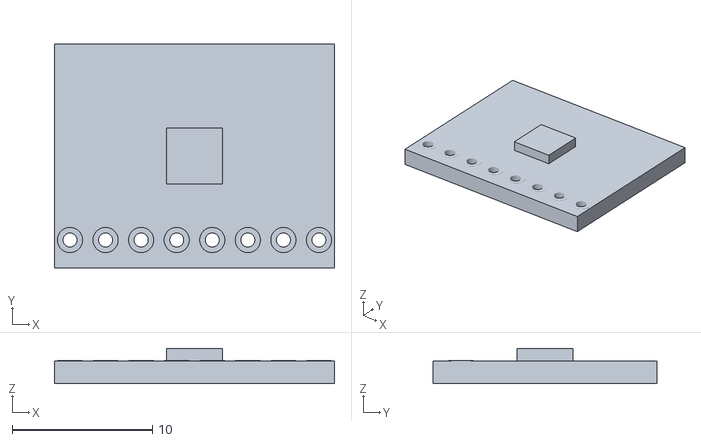
[picture p34: CAD file, 2026-09-28]
build/stl/mpu6050_7.stl
20.0 x 16.0 x 2.50
