B44ken/ria/build/stl/simplefocmini_dual_0.stl

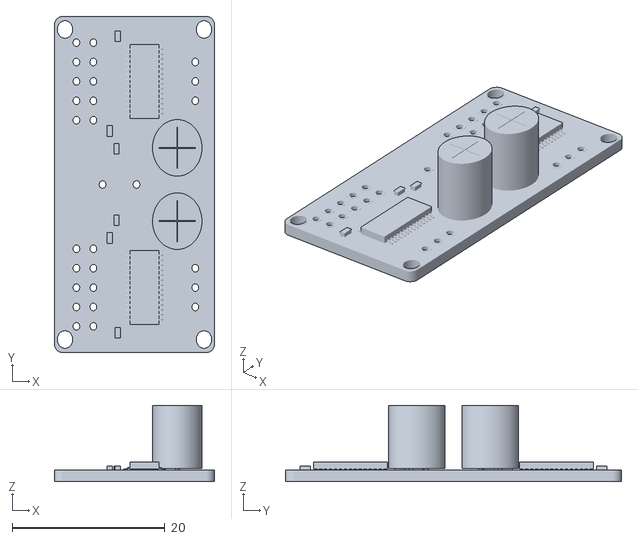
[picture p35: CAD file, 2026-09-28]
build/stl/simplefocmini_dual_0.stl
21.0 x 44.0 x 10.00
