B44ken/ria/build/stl/battery_shoe.stl

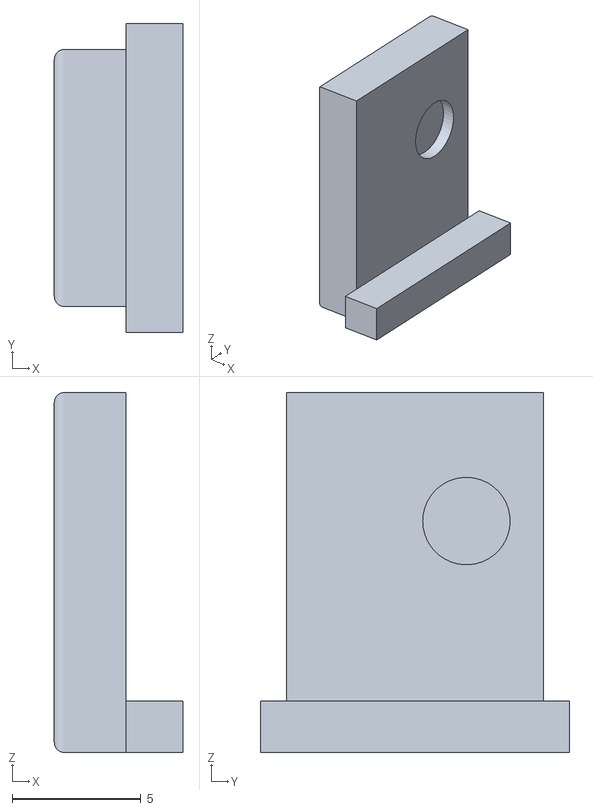
[picture p36: CAD file, 2026-09-28]
build/stl/battery_shoe.stl
5.00 x 12.0 x 14.0
