B44ken/ria/build/stl/tattu_lipo_5.stl

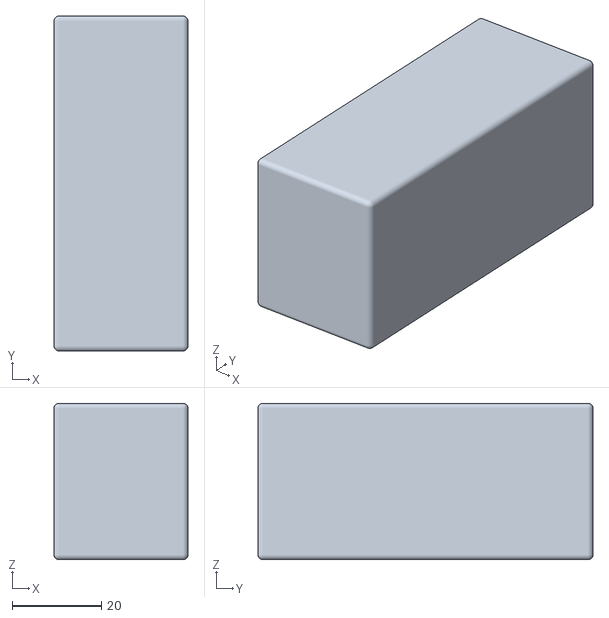
[picture p37: CAD file, 2026-09-28]
build/stl/tattu_lipo_5.stl
30.0 x 75.0 x 35.0
