B44ken/ria/(list of files, cad)

Other CAD files:
build/stl/planet_2.stl
build/stl/planet_bearing_0.stl
build/stl/planet_1.stl
build/stl/planet_bearing_2.stl
build/stl/magnet_knee.stl
build/stl/as5600_4.stl
build/stl/pipico_6.stl
build/stl/tray_spacer_0.stl
build/stl/simplefocmini_dual_1.stl
build/stl/tray_spacer_1.stl
build/stl/tray_spacer_2.stl
build/stl/hip_screw.stl
build/stl/pivot_nut.stl
build/stl/pivot_nut_insert.stl
build/stl/pivot_screw.stl
build/stl/planet_screw_0.stl
build/stl/planet_screw_1.stl
build/stl/planet_screw_2.stl
build/stl/pulley_screw.stl
build/stl/ring_screw_0.stl
build/stl/ring_screw_1.stl
