B44ken/ria/build/pcb-review/board.png

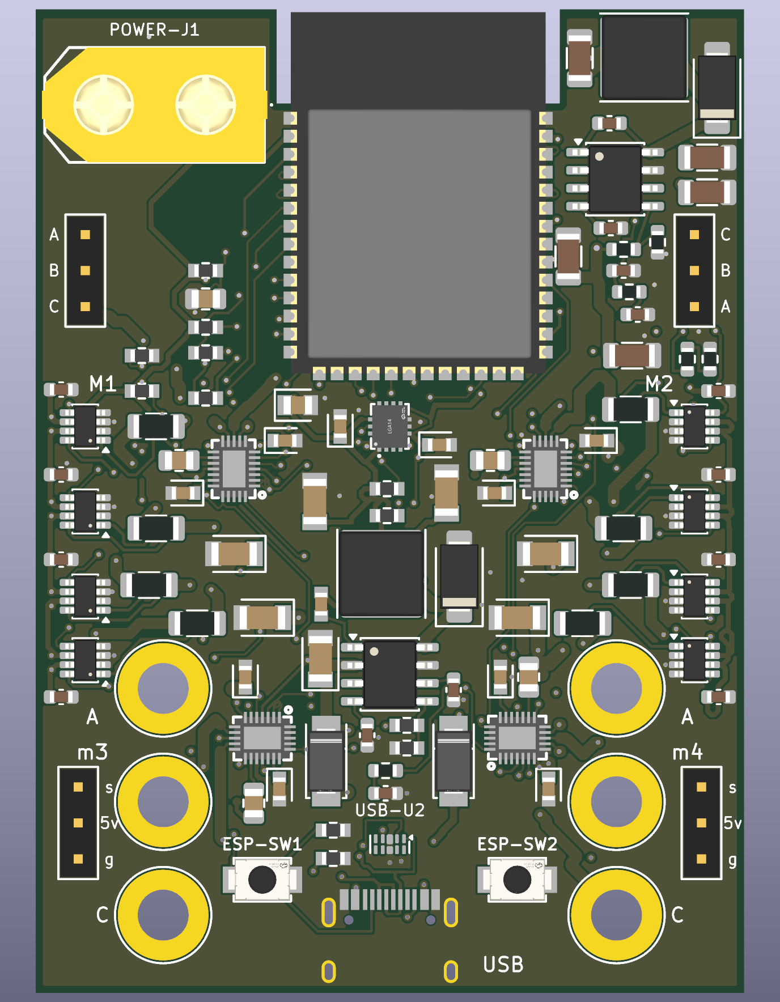
build/pcb-review/board.png
