B44ken/ria/build/pcb-review/current-sensing.png

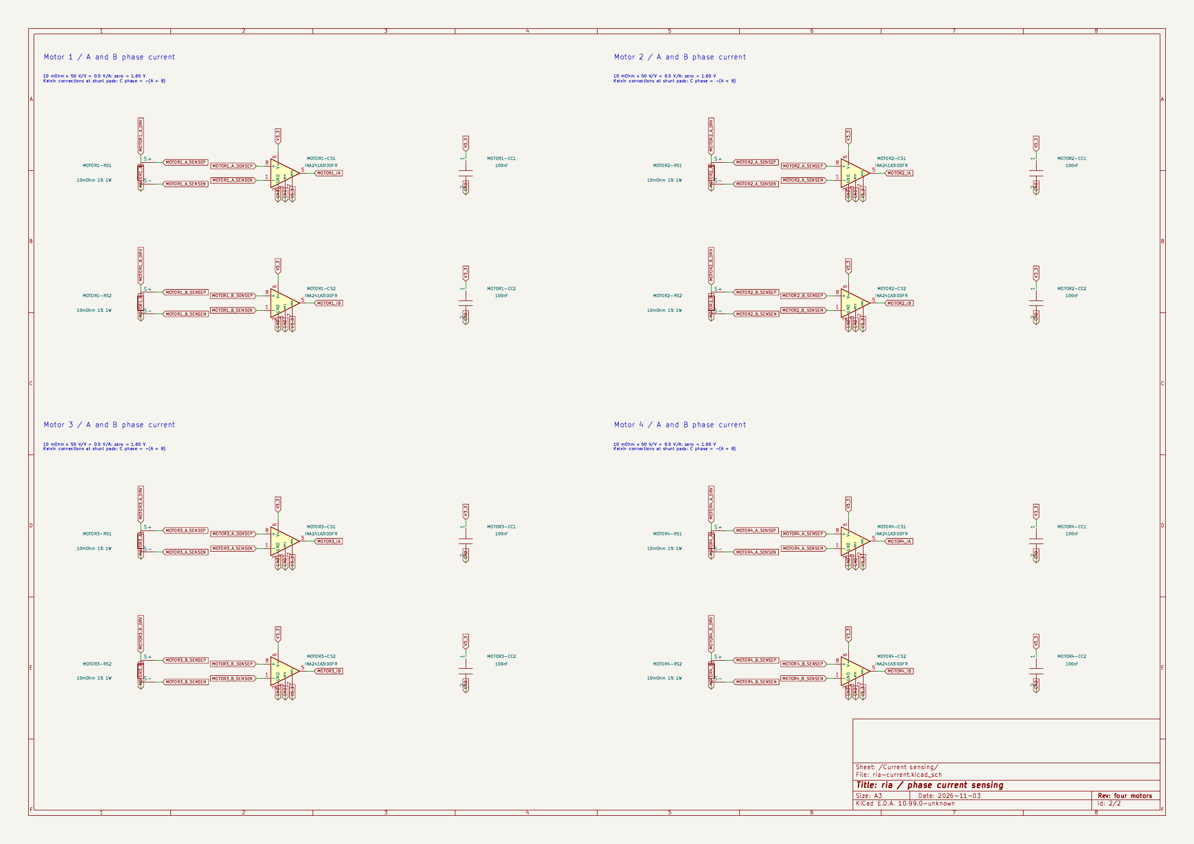
build/pcb-review/current-sensing.png
