B44ken/ria/build/pcb-review/layers/ria-B_Cu.png

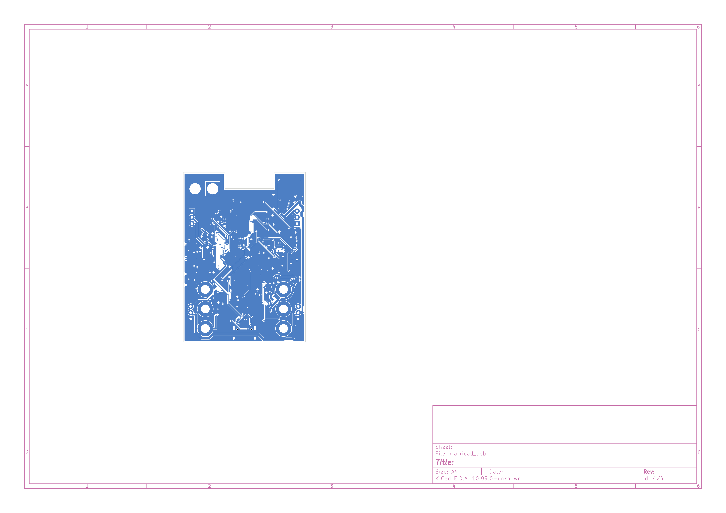
build/pcb-review/layers/ria-B_Cu.png
