B44ken/ria/build/pcb-review/layers/ria-In1_Cu.png

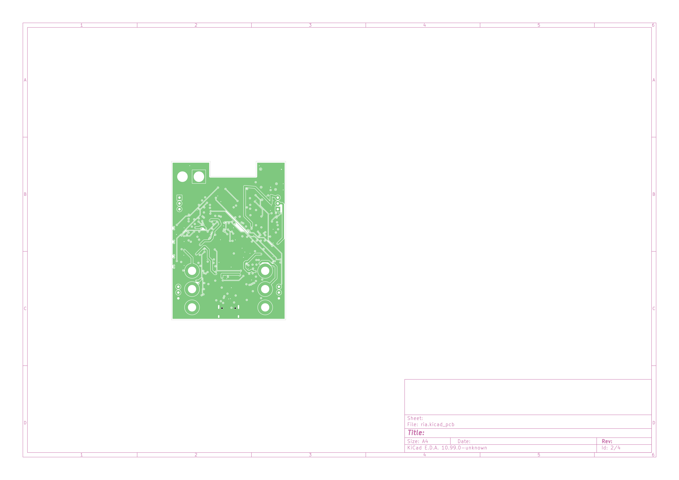
build/pcb-review/layers/ria-In1_Cu.png
