B44ken/ria/build/review/pr5-72f5b65/board.png

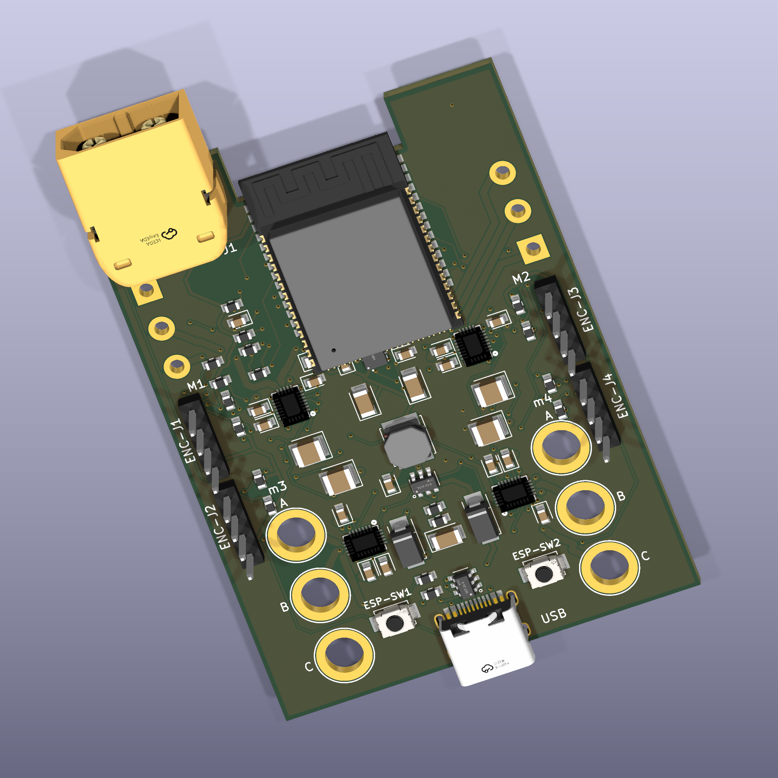
build/review/pr5-72f5b65/board.png
