B44ken/ria/build/review/pr5-72f5b65/jlc-driver-placement.jpg

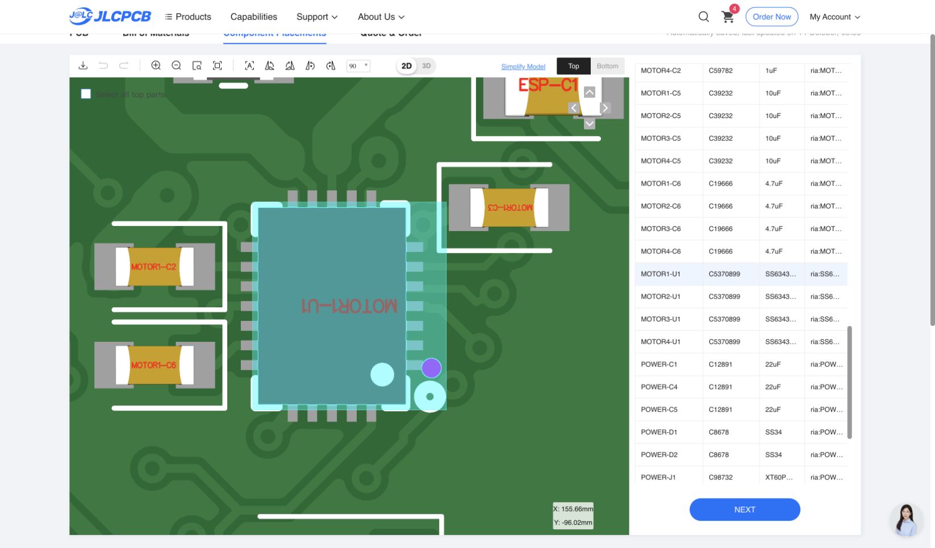
build/review/pr5-72f5b65/jlc-driver-placement.jpg
