B44ken/ria/build/review/pr5-72f5b65/jlc-imu-placement.jpg

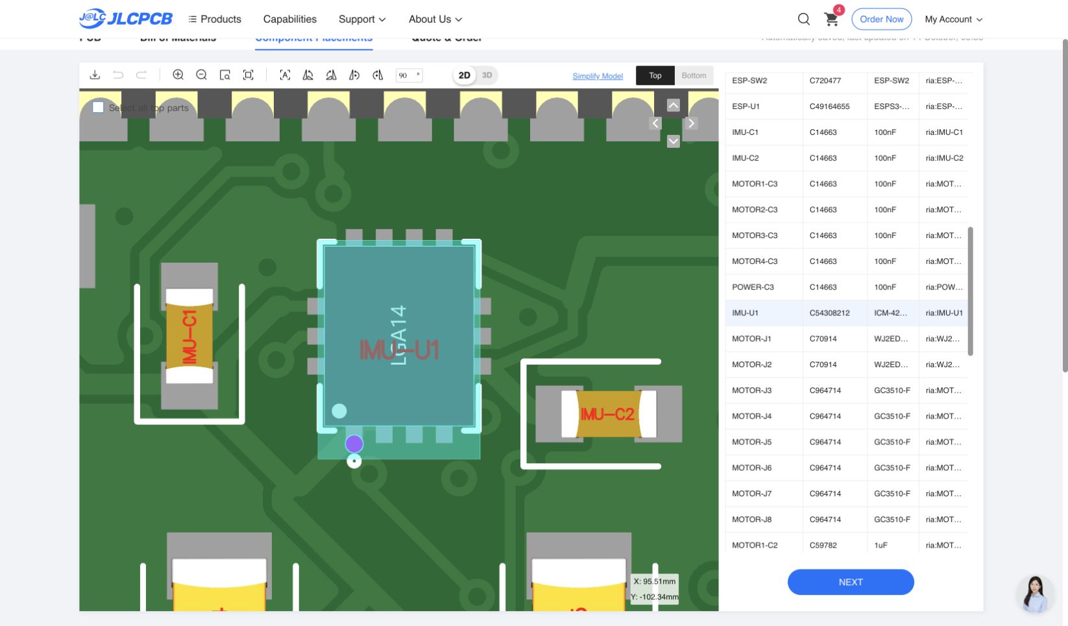
build/review/pr5-72f5b65/jlc-imu-placement.jpg
