B44ken/ria/build/review/pr5-72f5b65/quote.jpg

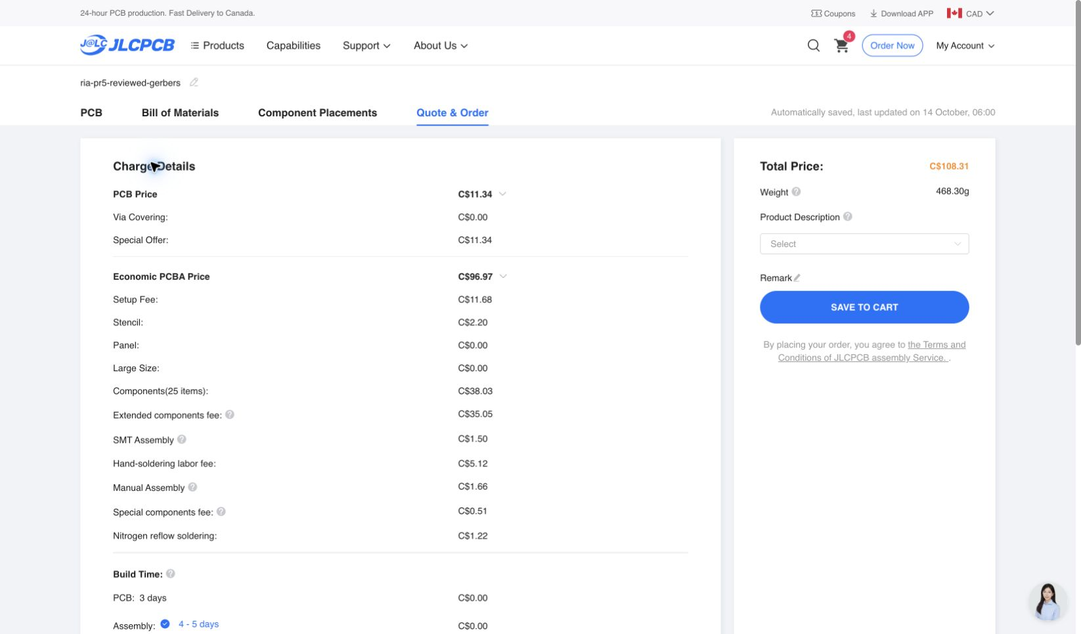
build/review/pr5-72f5b65/quote.jpg
