B44ken/ria/build/review/pr5-72f5b65/stock-shortage.jpg

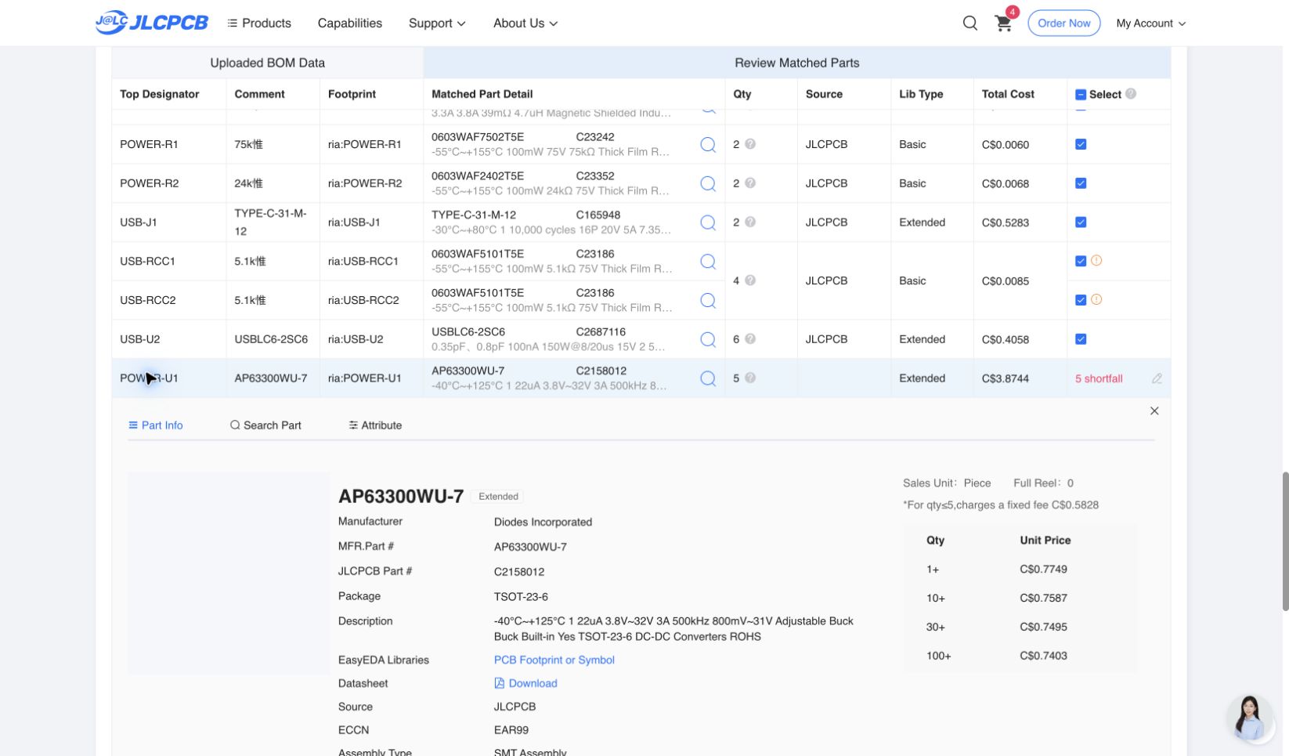
build/review/pr5-72f5b65/stock-shortage.jpg
