B44ken/ria/build/review/pr5-72f5b65/verify.txt

four layers, inner ground/battery planes, 69 top-mounted components, 59 connected nets, ss6343m pinout, mirrored 5.08 mm motor connectors and antenna-notch outline match
