B44ken/ria/build/pcb-review/schematic.pdf

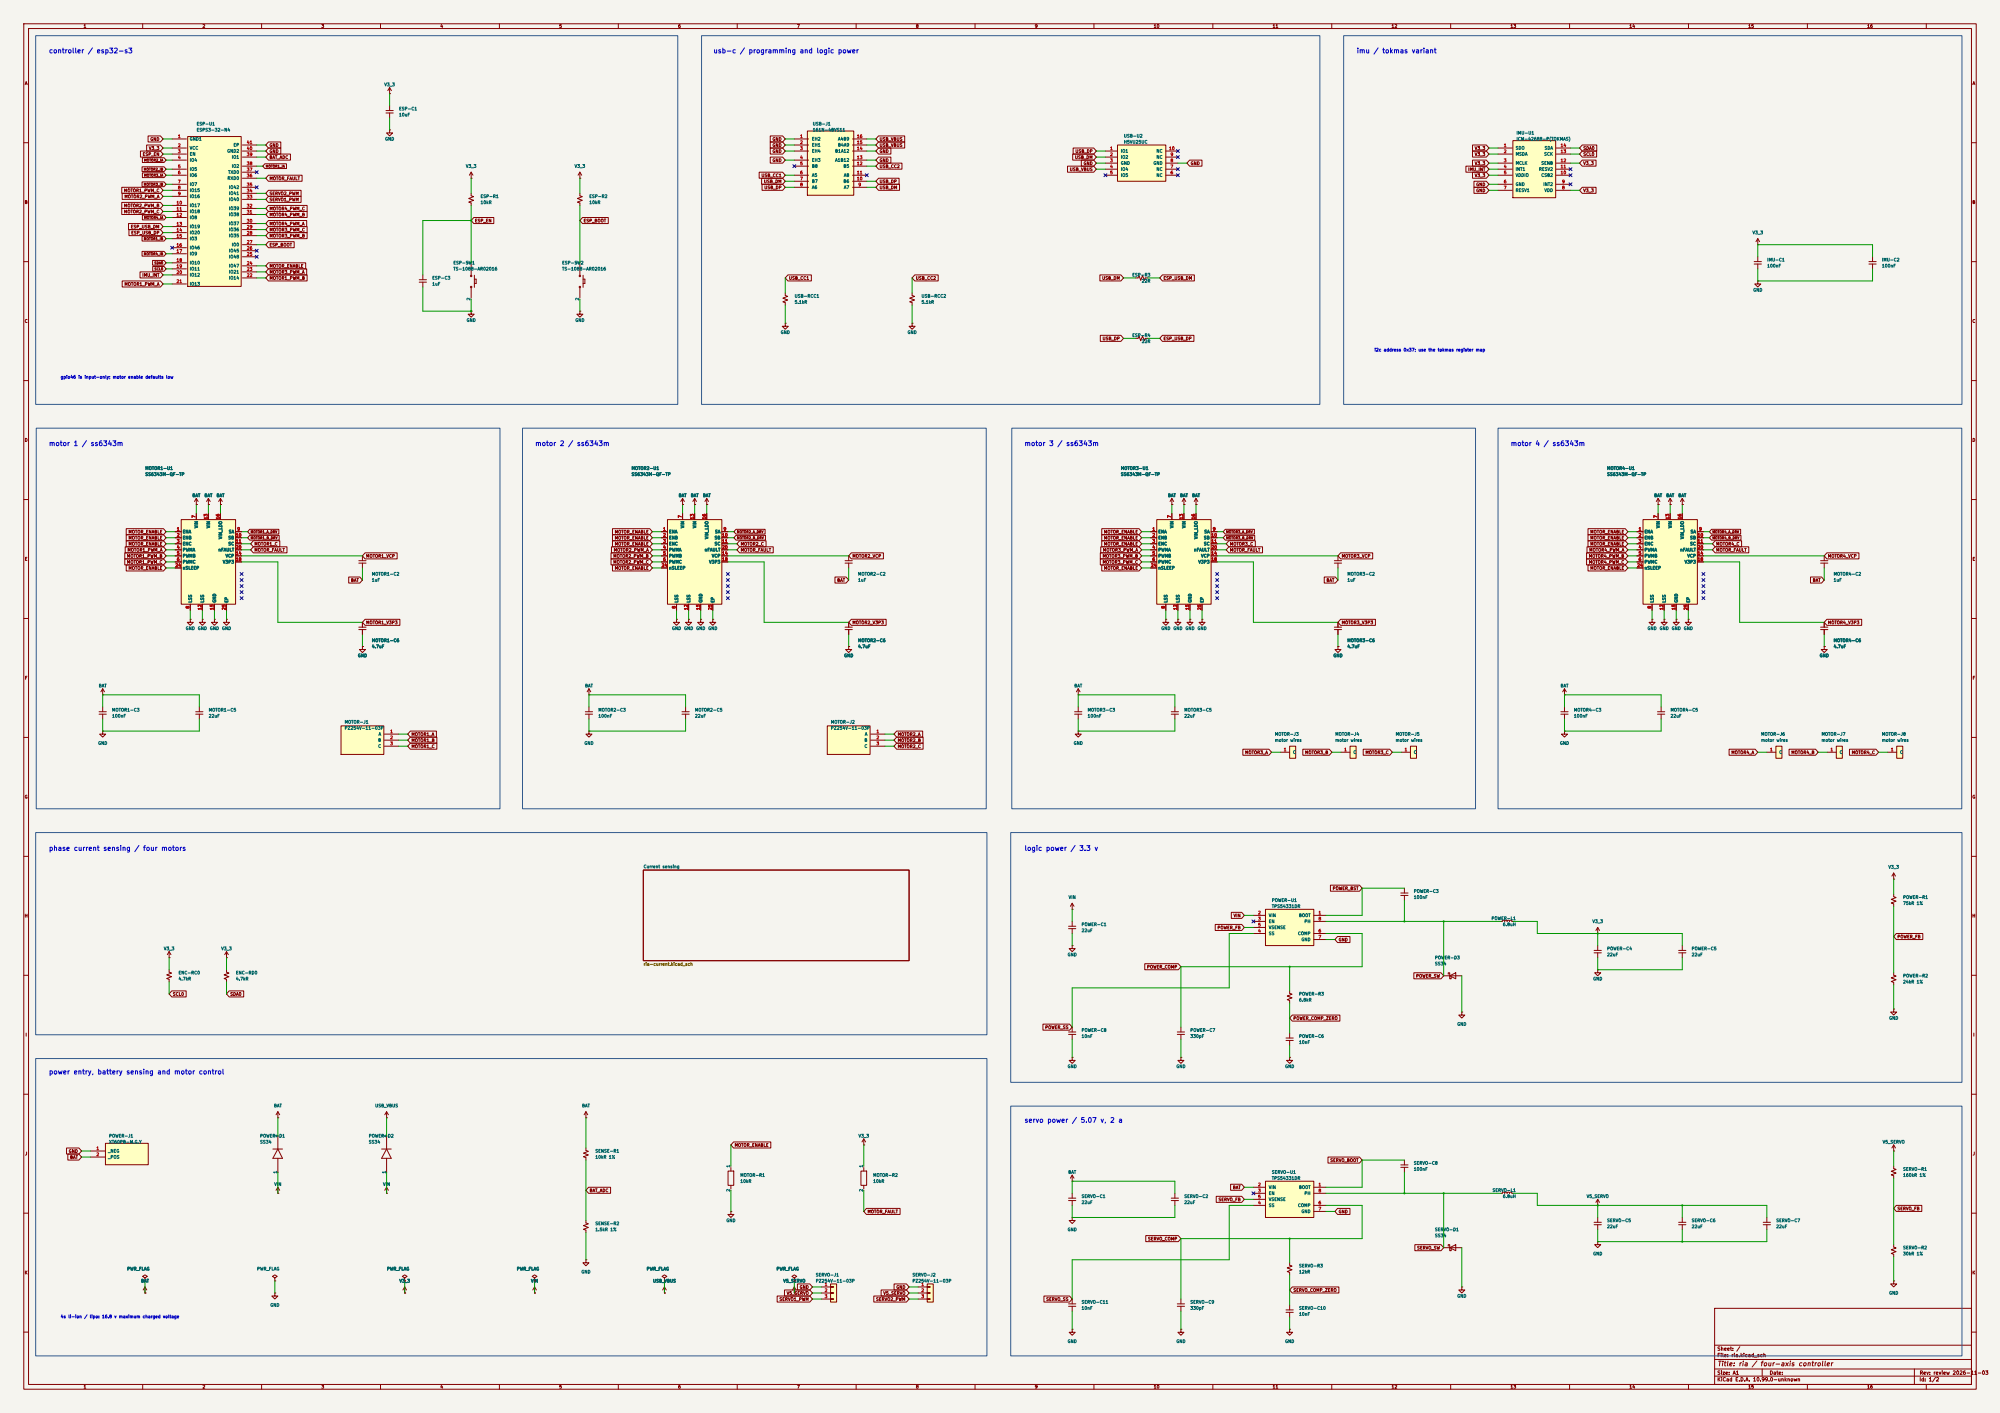
[picture p47: page 1]

i2c address 0x37; use the tokmas register map

gpio46 is input-only; motor enable defaults low

BAT BAT BAT GND GND GND

1 MOTOR-J3 motor wires GND

1 MOTOR-J7 motor wires GND

1 MOTOR-J8 motor wires GND

phase current sensing / four motors

power entry, battery sensing and motor control

4s li-ion / lipo: 16.8 v maximum charged voltage

Sheet: /
File: ria.kicad_sch
Title: ria / four-axis controller

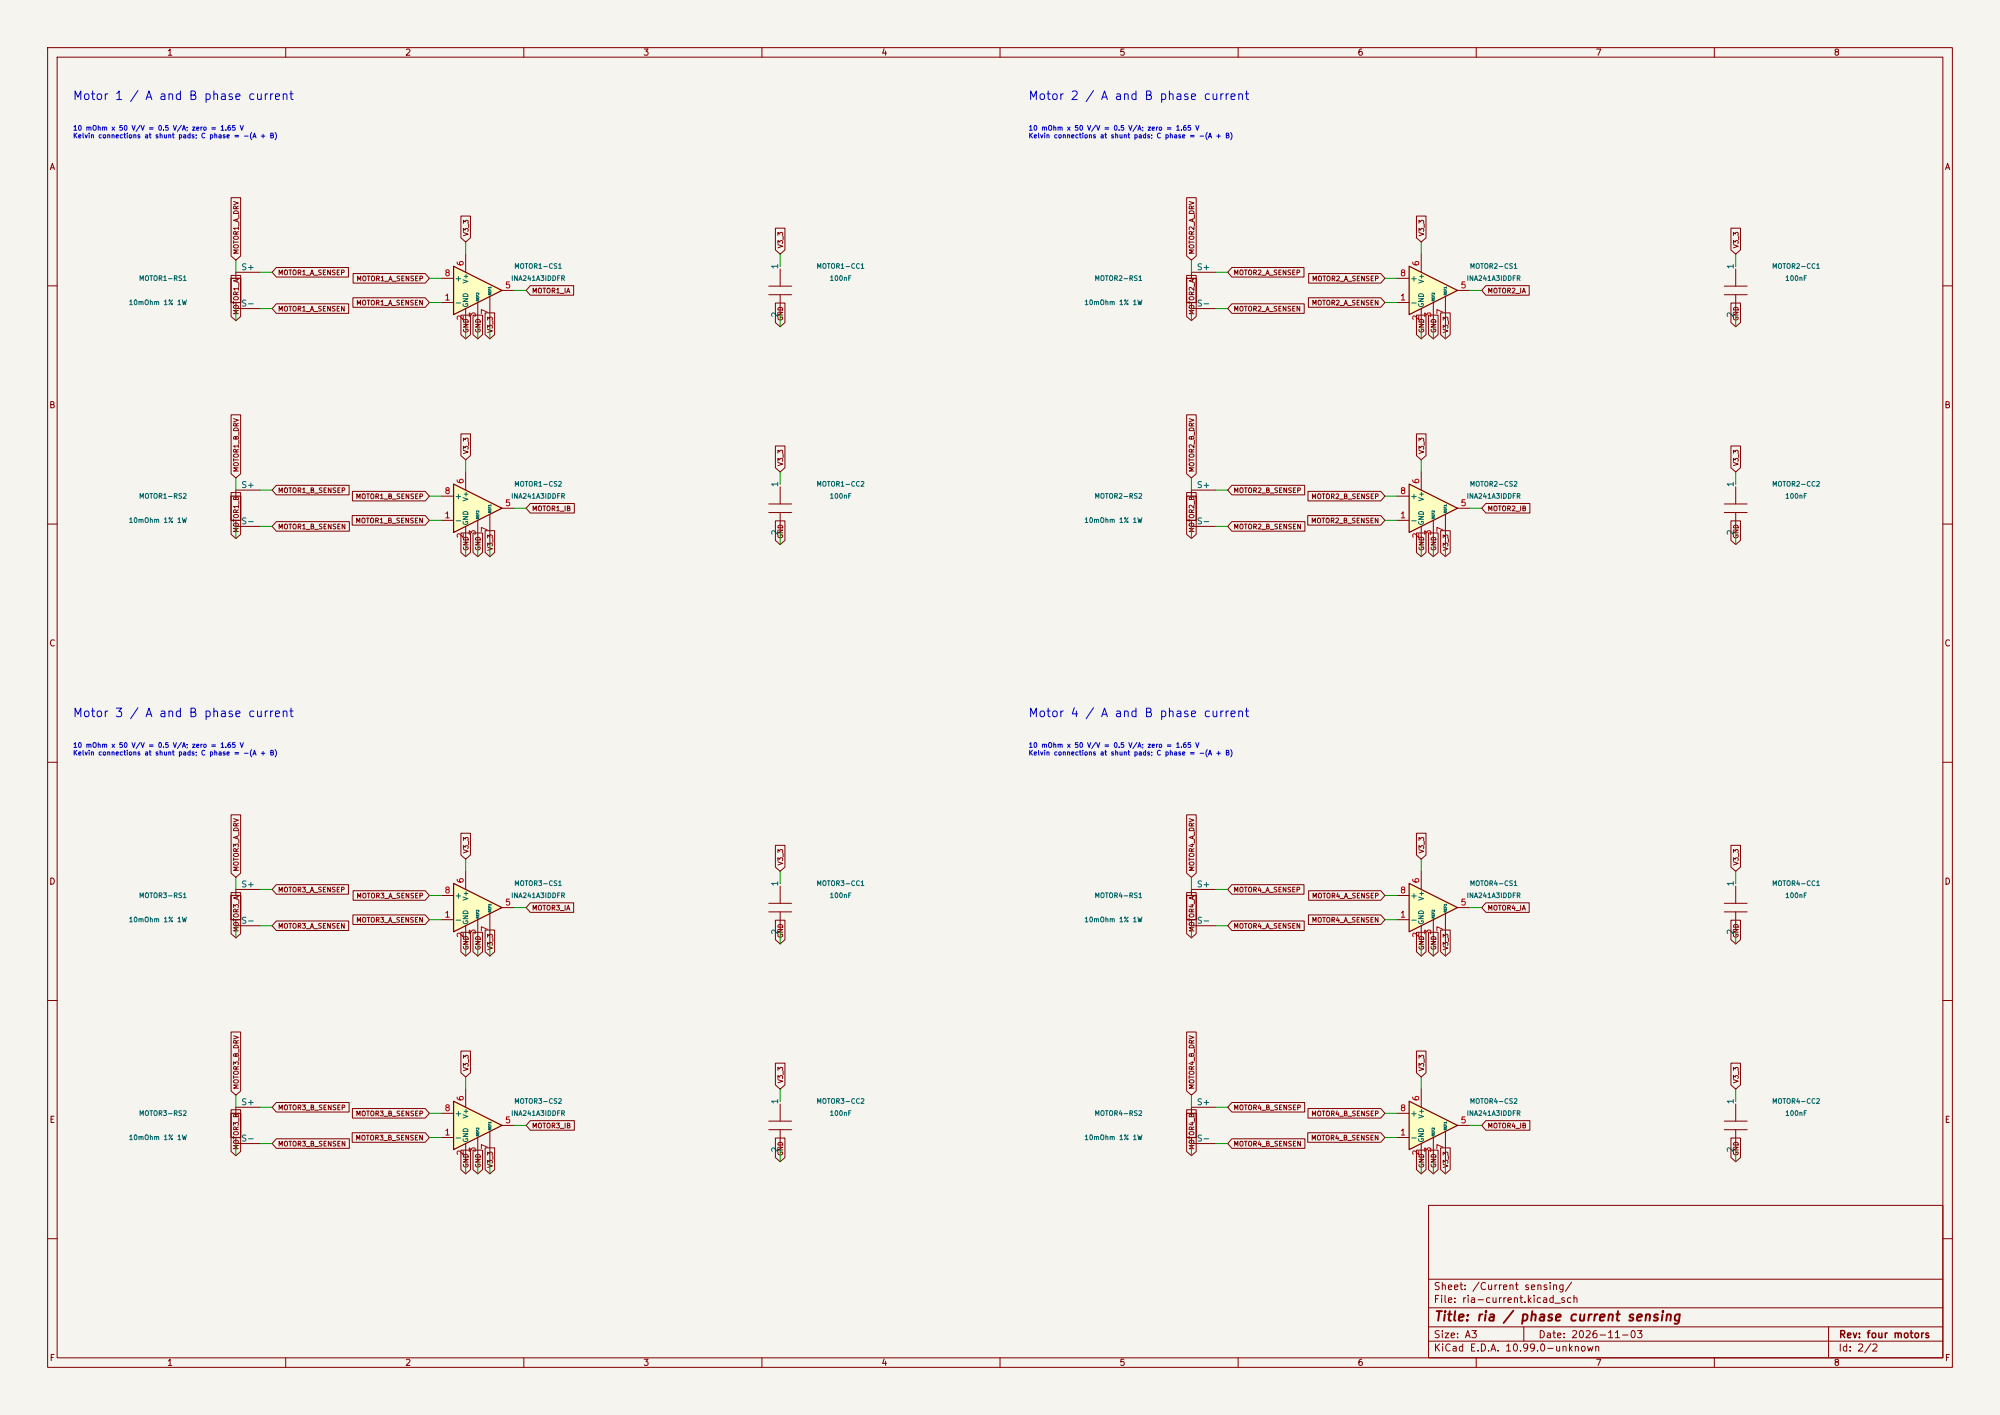
[picture p48: page 2]

Motor 1 / A and B phase current

Motor 2 / A and B phase current

10 mOhm x 50 V/V = 0.5 V/A; zero = 1.65 V Kelvin connections at shunt pads; C phase = -(A + B)

Motor 3 / A and B phase current

Motor 4 / A and B phase current

Sheet: /Current sensing/
File: ria-current.kicad_sch
Title: ria / phase current sensing

Size: A3 | Rev: four motors | F Date: 2026-11-03
KiCad E.D.A. 10.99.0-unknown | Id: 2/2
