B44ken/ria/pcb/ria.kicad_pcb

## KiCad design pcb/ria.kicad_pcb (2026-11-03)

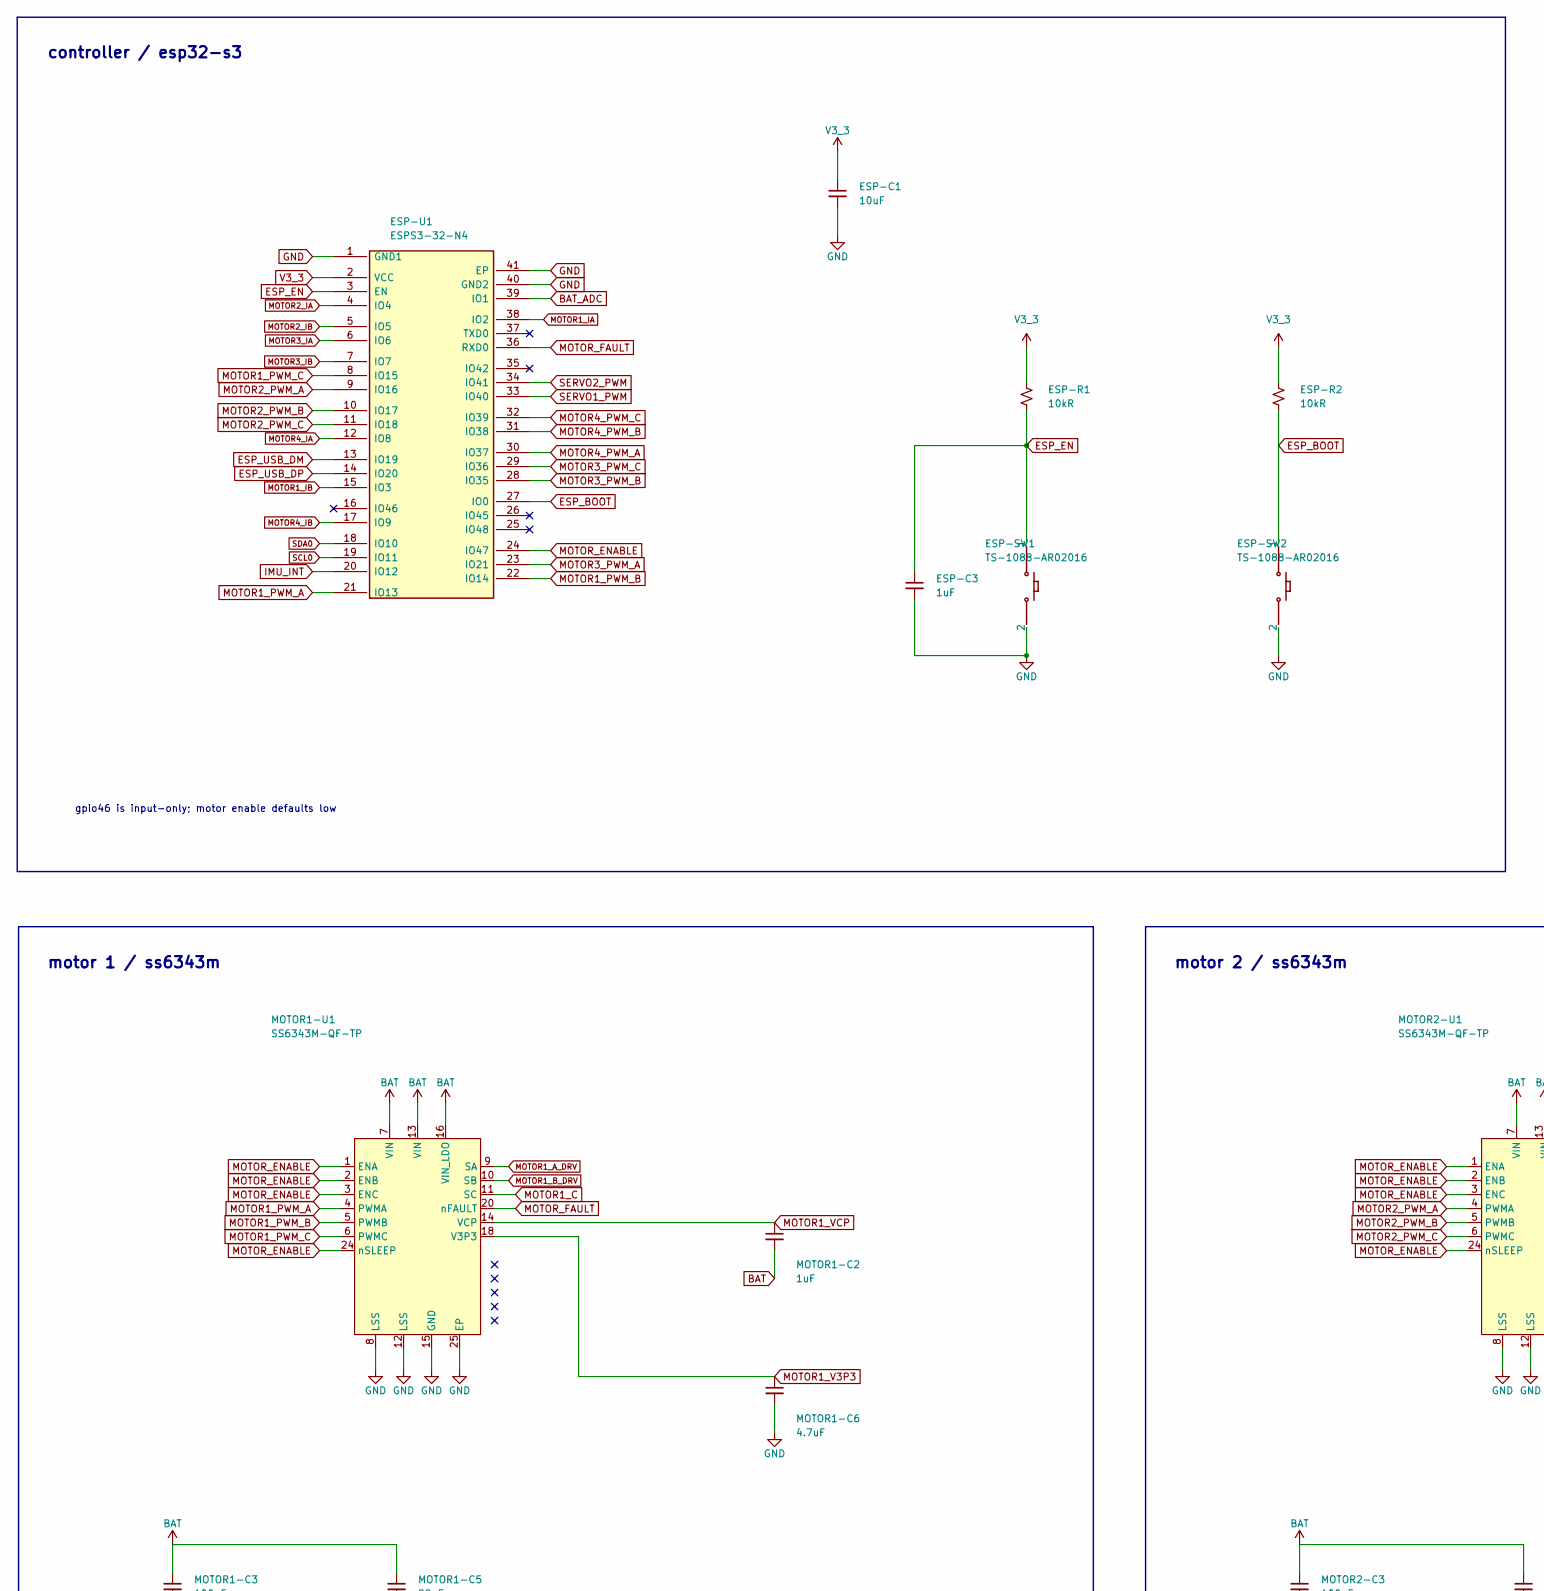
[picture p49: schematic ria.kicad_sch, ria / four-axis controller, part in row 1, column 1]

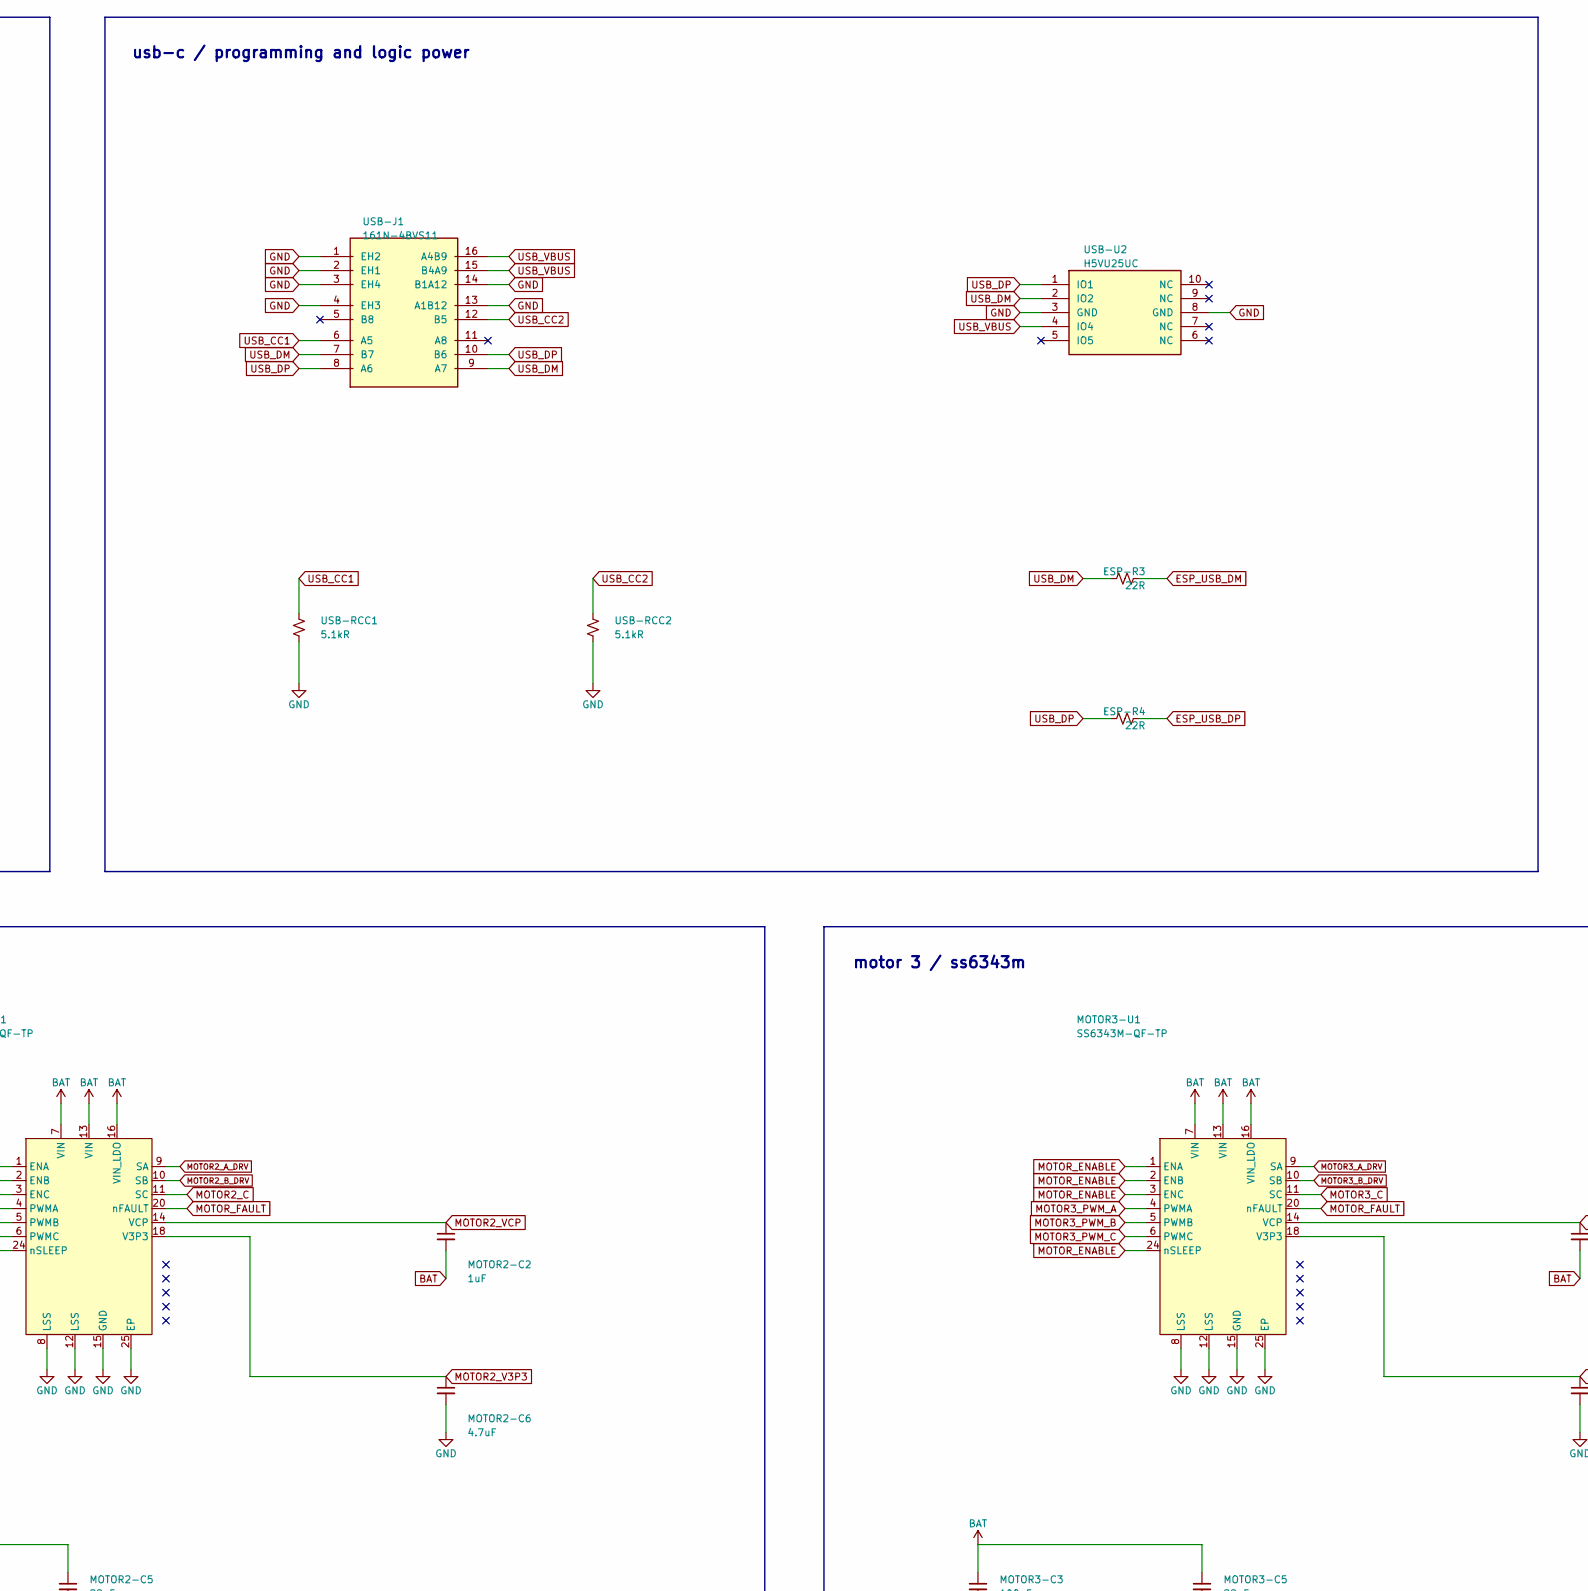
[picture p50: schematic ria.kicad_sch, ria / four-axis controller, part in row 1, column 2]

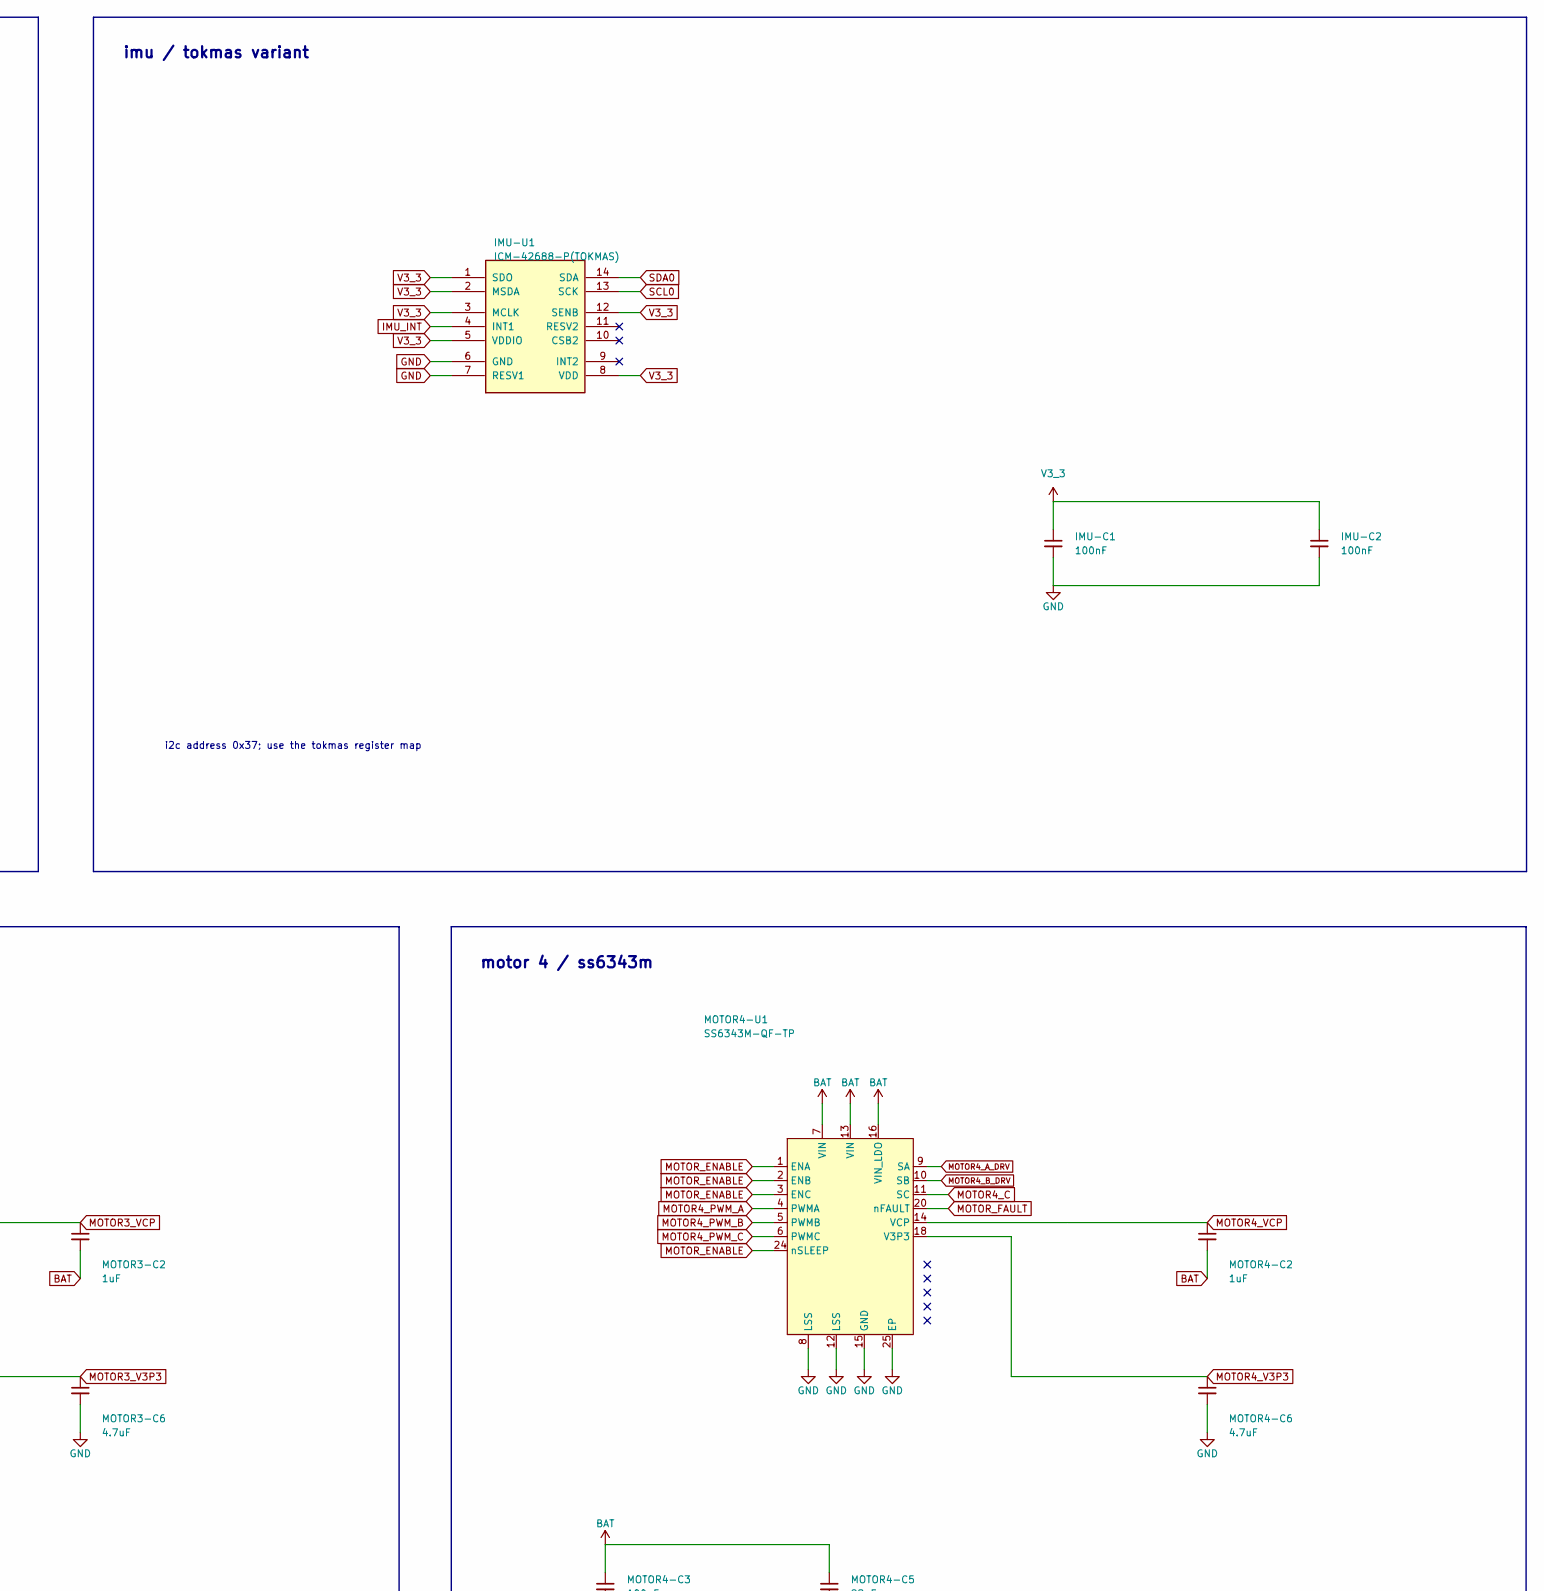
[picture p51: schematic ria.kicad_sch, ria / four-axis controller, part in row 1, column 3]

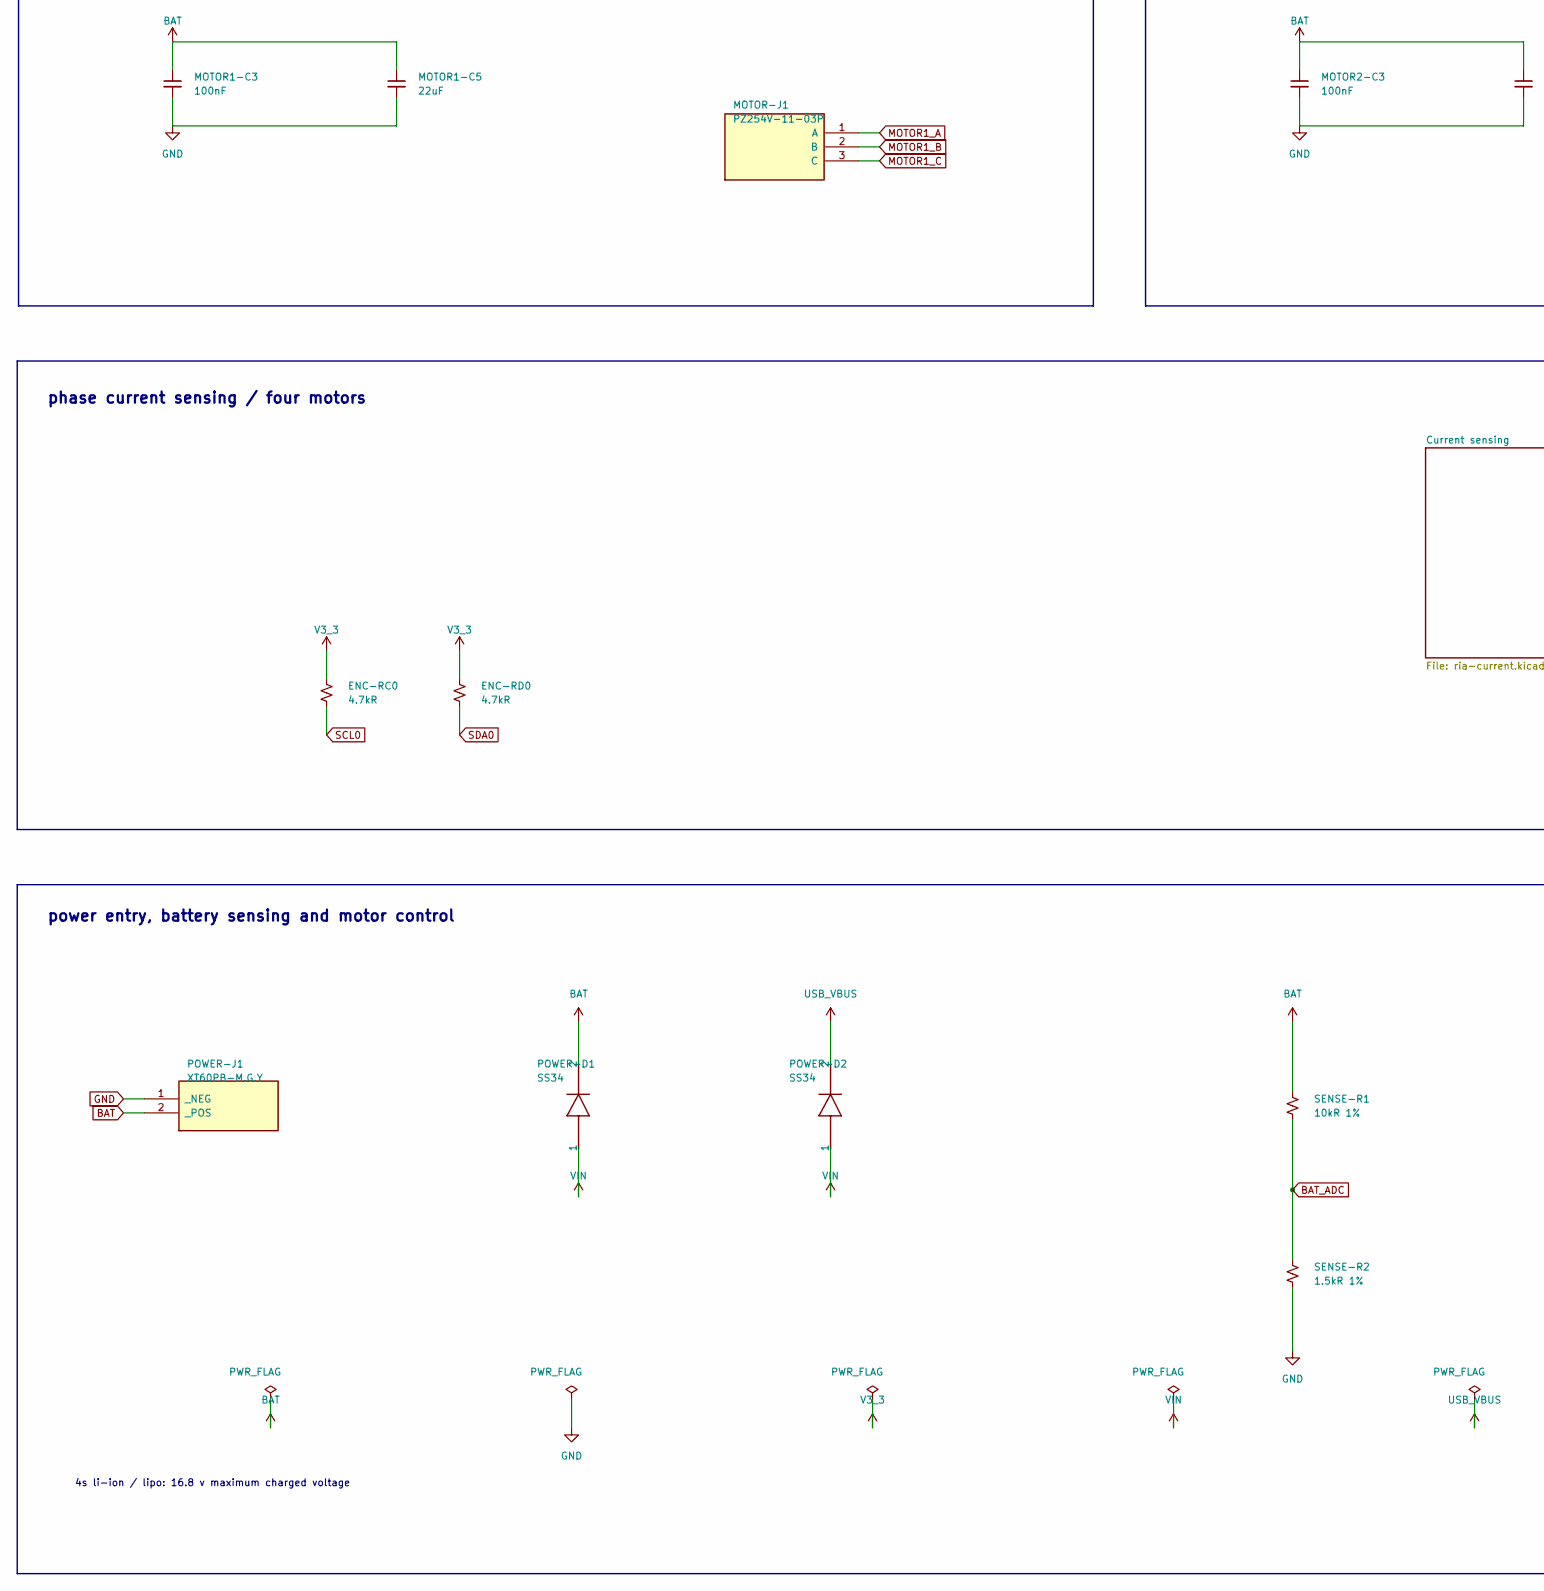
[picture p52: schematic ria.kicad_sch, ria / four-axis controller, part in row 2, column 1]

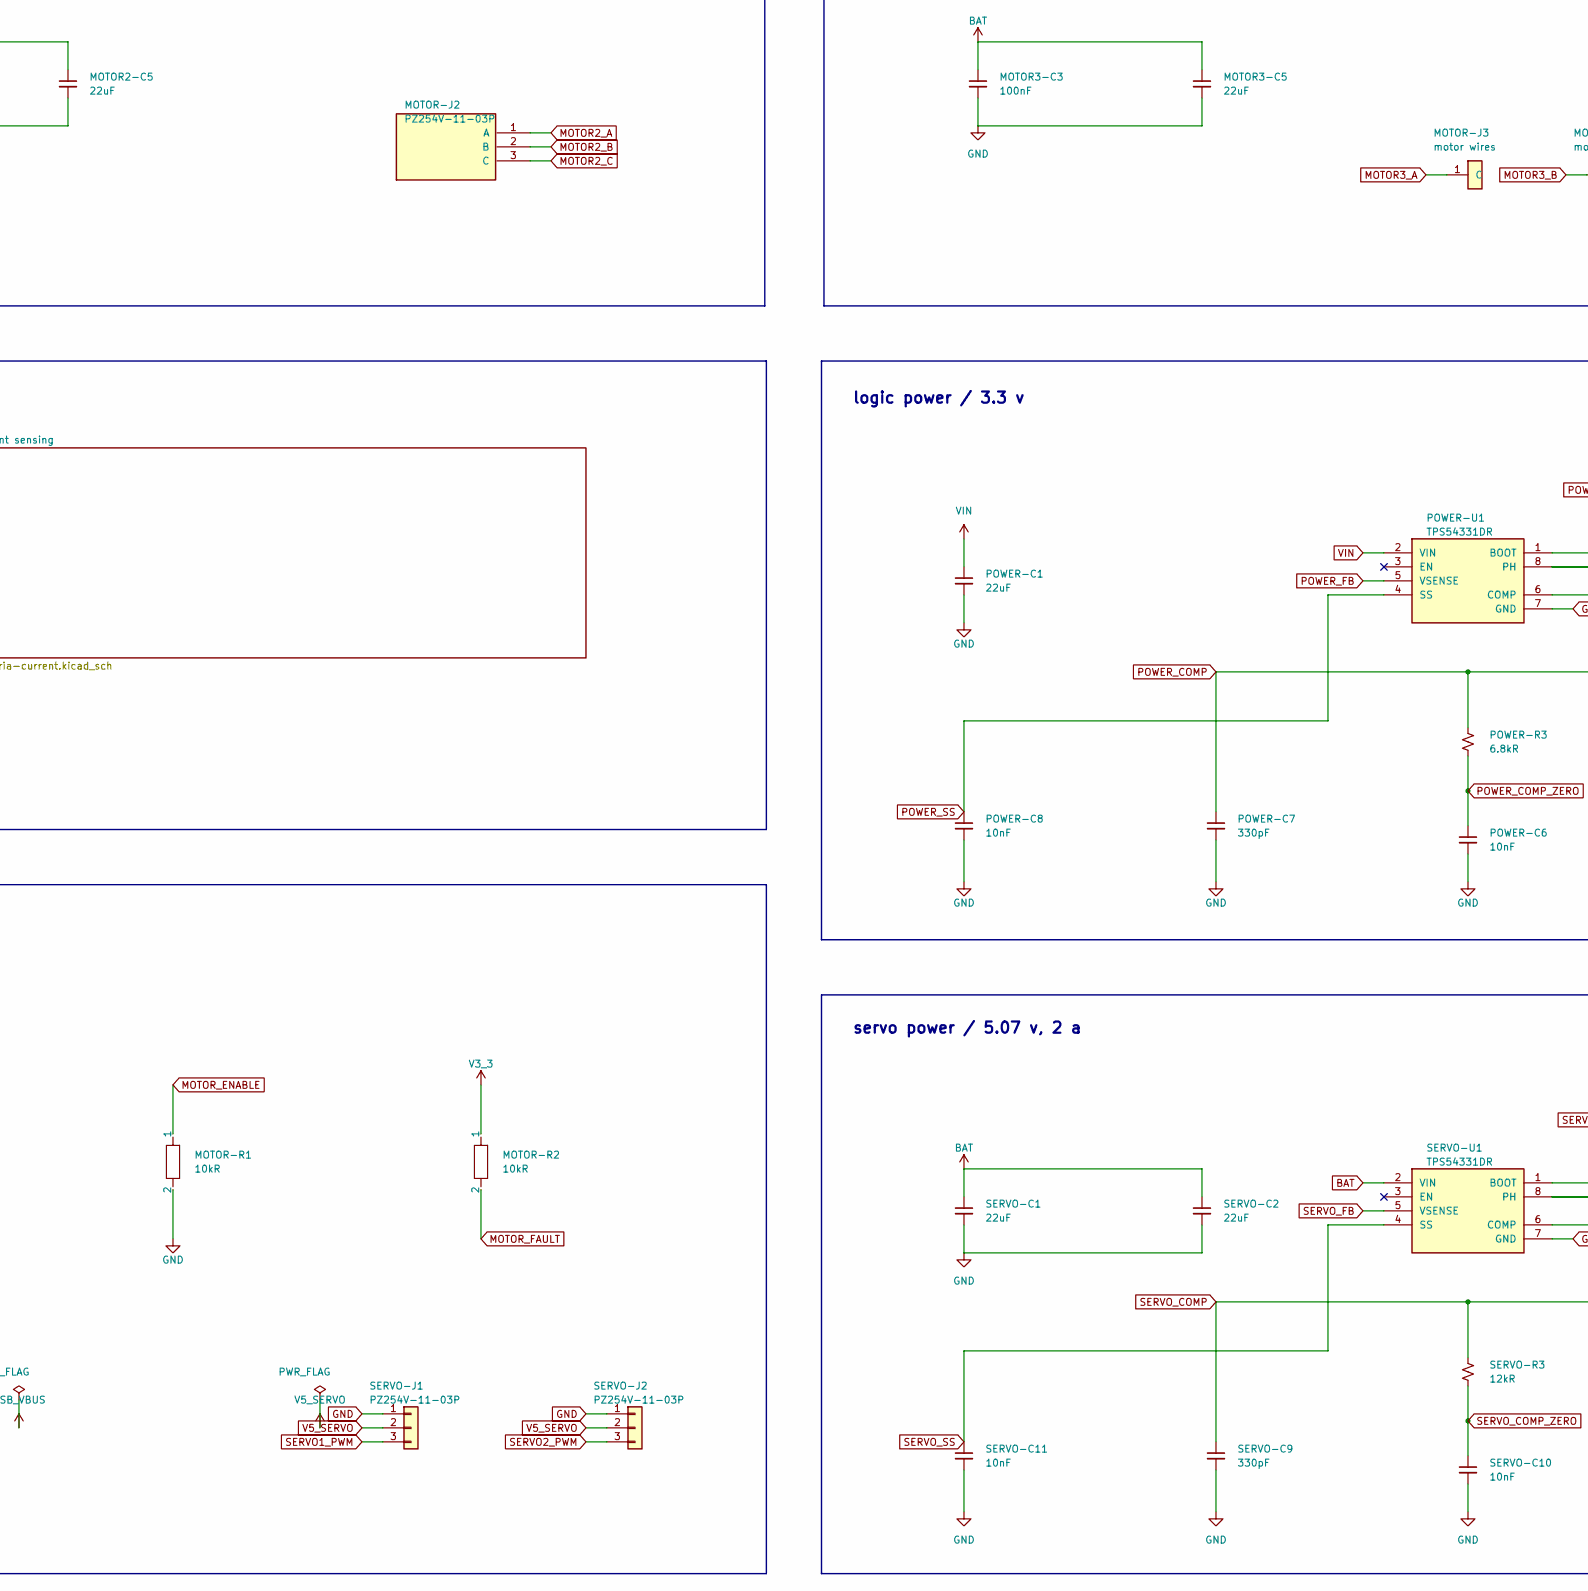
[picture p53: schematic ria.kicad_sch, ria / four-axis controller, part in row 2, column 2]

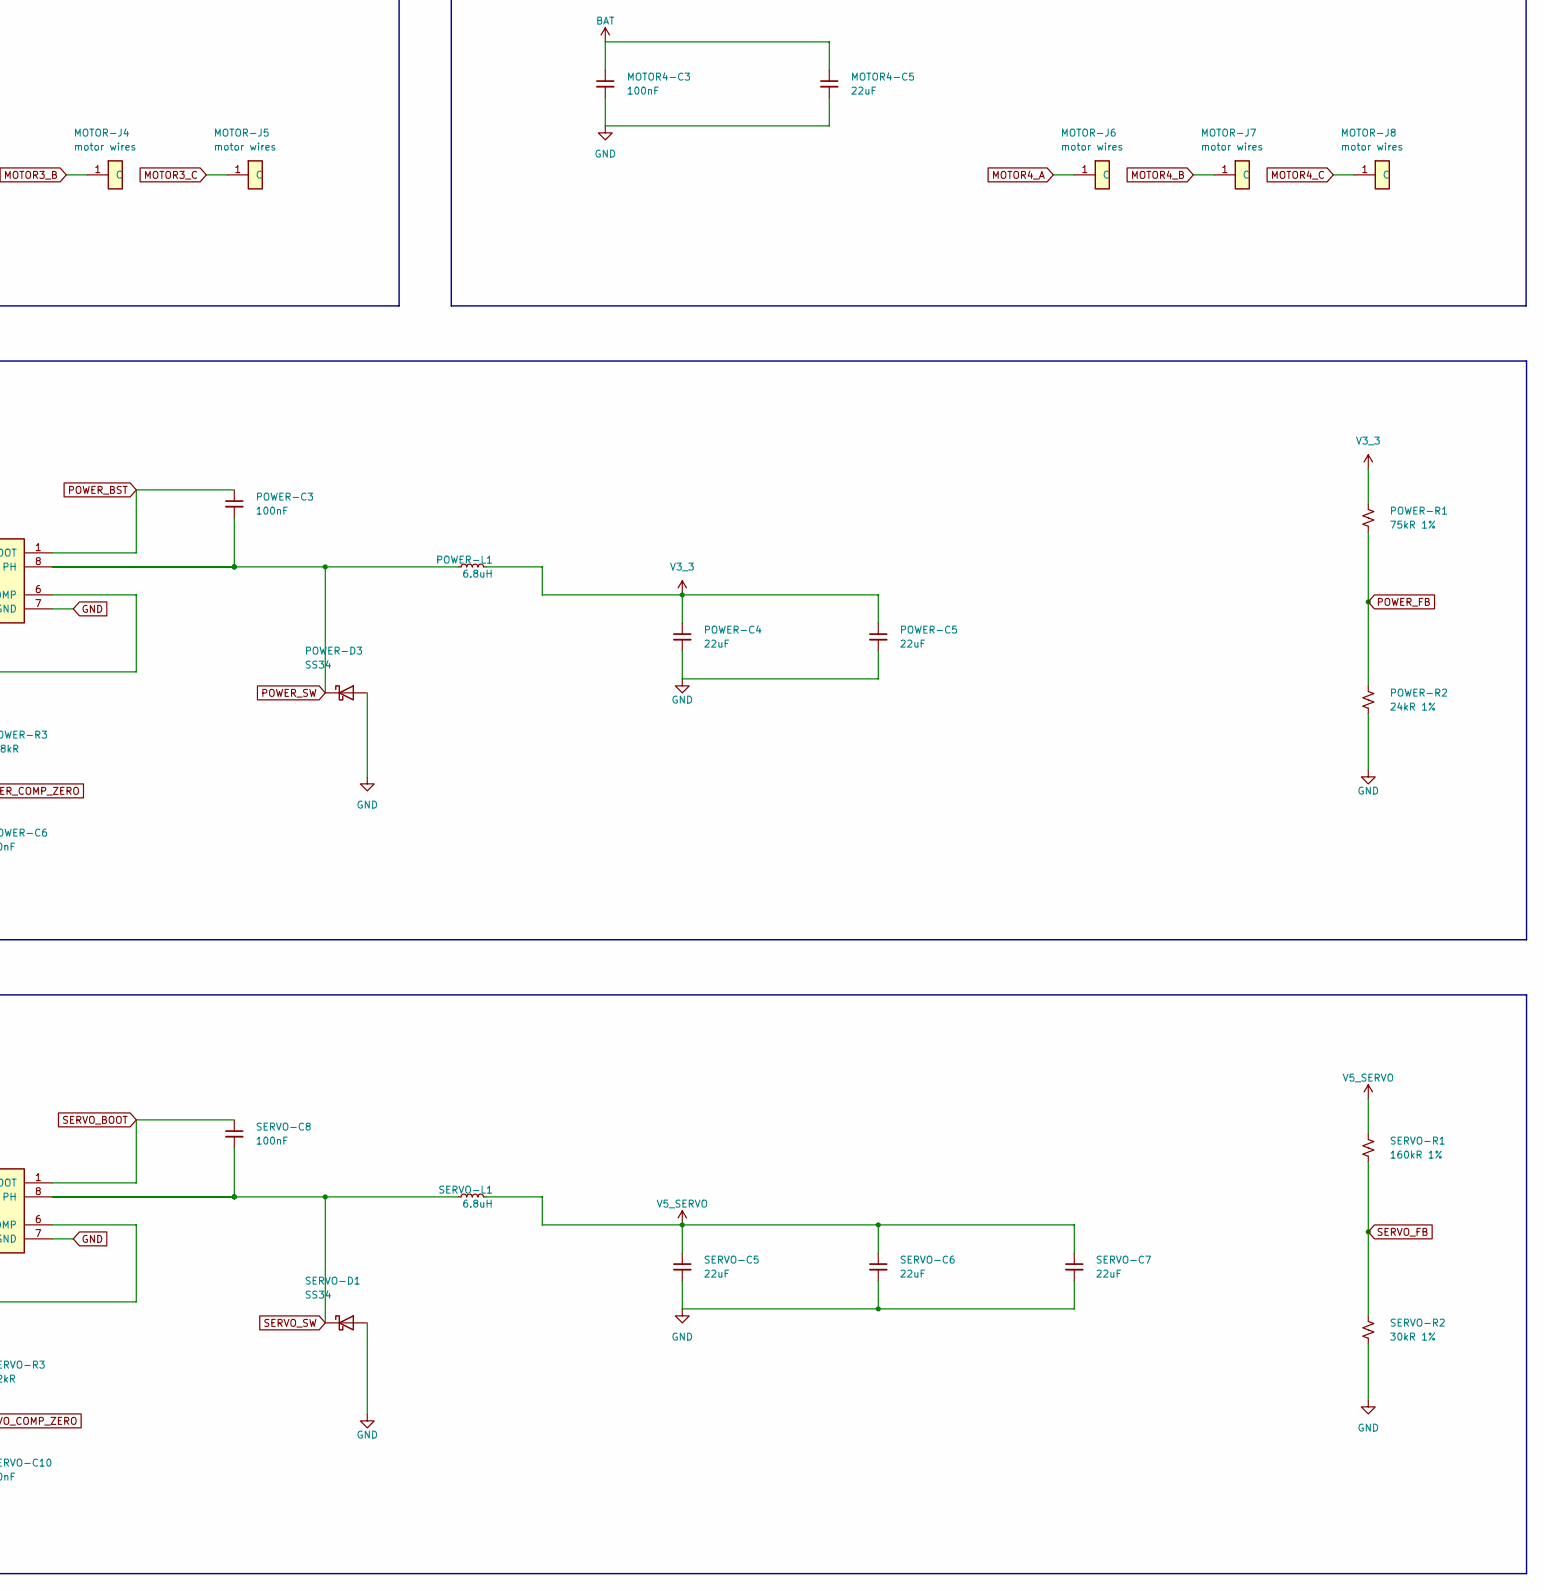
[picture p54: schematic ria.kicad_sch, ria / four-axis controller, part in row 2, column 3]

Parts:
ENC-RC0: 4.7kR; ENC-RC0; MPN 0603WAF4701T5E; LCSC C23162
ENC-RD0: 4.7kR; ENC-RD0; MPN 0603WAF4701T5E; LCSC C23162
ESP-C1: 10uF; ESP-C1; MPN CL21A106KAYNNNE; LCSC C15850
ESP-C3: 1uF; C_0805_2012Metric; MPN CL21B105KBFNNNE; LCSC C28323
ESP-R1: 10kR; ESP-R1; MPN 0603WAF1002T5E; LCSC C25804
ESP-R2: 10kR; ESP-R2; MPN 0603WAF1002T5E; LCSC C25804
ESP-R3: 22R; ESP-R3; MPN 0603WAF220JT5E; LCSC C23345
ESP-R4: 22R; ESP-R4; MPN 0603WAF220JT5E; LCSC C23345
ESP-SW1: TS-1088-AR02016; ESP-SW1; MPN TS-1088-AR02016; LCSC C720477
ESP-SW2: TS-1088-AR02016; ESP-SW2; MPN TS-1088-AR02016; LCSC C720477
ESP-U1: ESPS3-32-N4; ESP-U1; MPN ESPS3-32-N4; LCSC C49164655
IMU-C1: 100nF; IMU-C1; MPN CC0603KRX7R9BB104; LCSC C14663
IMU-C2: 100nF; IMU-C2; MPN CC0603KRX7R9BB104; LCSC C14663
IMU-U1: ICM-42688-P(TOKMAS); IMU-U1; MPN ICM-42688-P(TOKMAS); LCSC C54308212
MOTOR1-C2, MOTOR2-C2, MOTOR3-C2, MOTOR4-C2: 1uF; C_0805_2012Metric; MPN CL21B105KBFNNNE; LCSC C28323
MOTOR1-C3: 100nF; MOTOR1-C3; MPN CC0603KRX7R9BB104; LCSC C14663
MOTOR1-C5, MOTOR2-C5, MOTOR3-C5, MOTOR4-C5: 22uF; C_1206_3216Metric; MPN CL31A226KAHNNNE; LCSC C12891
MOTOR1-C6: 4.7uF; MOTOR1-C6; MPN CL10A475KO8NNNC; LCSC C19666
MOTOR1-U1, MOTOR2-U1, MOTOR3-U1, MOTOR4-U1: SS6343M-QF-TP; MPN SS6343M-QF-TP; LCSC C5370899
MOTOR2-C3: 100nF; MOTOR2-C3; MPN CC0603KRX7R9BB104; LCSC C14663
MOTOR2-C6: 4.7uF; MOTOR2-C6; MPN CL10A475KO8NNNC; LCSC C19666
MOTOR3-C3: 100nF; MOTOR3-C3; MPN CC0603KRX7R9BB104; LCSC C14663
MOTOR3-C6: 4.7uF; MOTOR3-C6; MPN CL10A475KO8NNNC; LCSC C19666
MOTOR4-C3: 100nF; MOTOR4-C3; MPN CC0603KRX7R9BB104; LCSC C14663
MOTOR4-C6: 4.7uF; MOTOR4-C6; MPN CL10A475KO8NNNC; LCSC C19666
MOTOR-J1: PZ254V-11-03P; MOTOR-J1; MPN PZ254V-11-03P; LCSC C2937625
MOTOR-J2: PZ254V-11-03P; MOTOR-J2; MPN PZ254V-11-03P; LCSC C2937625
MOTOR-J3: motor wires; MOTOR-J3A
MOTOR-J4: motor wires; MOTOR-J3B
MOTOR-J5: motor wires; MOTOR-J3C
MOTOR-J6: motor wires; MOTOR-J4A
MOTOR-J7: motor wires; MOTOR-J4B
MOTOR-J8: motor wires; MOTOR-J4C
MOTOR-R1: 10kR; MOTOR-RE; MPN 0603WAF1002T5E; LCSC C25804
MOTOR-R2: 10kR; MOTOR-RS; MPN 0603WAF1002T5E; LCSC C25804
POWER-C1: 22uF; POWER-C1; MPN CL31A226KAHNNNE; LCSC C12891
POWER-C3: 100nF; POWER-C3; MPN CC0603KRX7R9BB104; LCSC C14663
POWER-C4: 22uF; POWER-C4; MPN CL31A226KAHNNNE; LCSC C12891
POWER-C5: 22uF; POWER-C5; MPN CL31A226KAHNNNE; LCSC C12891
POWER-C6: 10nF; POWER-C6; MPN 0603B103K500NT; LCSC C57112
POWER-C7: 330pF; POWER-C7; MPN CL10C331JB8NNNC; LCSC C1664
POWER-C8: 10nF; POWER-C8; MPN 0603B103K500NT; LCSC C57112
POWER-D1: SS34; POWER-D1; MPN SS34; LCSC C8678
POWER-D2: SS34; POWER-D2; MPN SS34; LCSC C8678
POWER-D3: SS34; POWER-D3; MPN SS34; LCSC C8678
POWER-J1: XT60PB-M.G.Y; POWER-J1; MPN XT60PB-M.G.Y; LCSC C19268037
POWER-L1: 6.8uH; POWER-L1; MPN FNR6045S6R8MT; LCSC C168072
POWER-R1: 75kR 1%; POWER-R1; MPN 0603WAF7502T5E; LCSC C23242
POWER-R2: 24kR 1%; POWER-R2; MPN 0603WAF2402T5E; LCSC C23352
POWER-R3: 6.8kR; POWER-R3; MPN 0603WAF6801T5E; LCSC C23212
POWER-U1: TPS54331DR; POWER-U1; MPN TPS54331DR; LCSC C9865
SENSE-R1: 10kR 1%; SENSE-R1; MPN 0603WAF1002T5E; LCSC C25804
SENSE-R2: 1.5kR 1%; SENSE-R2; MPN 0603WAF1501T5E; LCSC C22843
SERVO-C1: 22uF; SERVO-C1; MPN CL31A226KAHNNNE; LCSC C12891
SERVO-C2: 22uF; SERVO-C2; MPN CL31A226KAHNNNE; LCSC C12891
SERVO-C5: 22uF; SERVO-C5; MPN CL31A226KAHNNNE; LCSC C12891
SERVO-C6: 22uF; SERVO-C6; MPN CL31A226KAHNNNE; LCSC C12891
SERVO-C7: 22uF; SERVO-C7; MPN CL31A226KAHNNNE; LCSC C12891
SERVO-C8: 100nF; SERVO-C8; MPN CC0603KRX7R9BB104; LCSC C14663
SERVO-C9: 330pF; SERVO-C9; MPN CL10C331JB8NNNC; LCSC C1664
SERVO-C10: 10nF; SERVO-C10; MPN 0603B103K500NT; LCSC C57112
SERVO-C11: 10nF; SERVO-C11; MPN 0603B103K500NT; LCSC C57112
SERVO-D1: SS34; SERVO-D1; MPN SS34; LCSC C8678
SERVO-J1: PZ254V-11-03P; SERVO-J1; MPN PZ254V-11-03P; LCSC C2937625
SERVO-J2: PZ254V-11-03P; SERVO-J2; MPN PZ254V-11-03P; LCSC C2937625
SERVO-L1: 6.8uH; SERVO-L1; MPN FNR6045S6R8MT; LCSC C168072
SERVO-R1: 160kR 1%; SERVO-R1; MPN 0603WAF1603T5E; LCSC C22813
SERVO-R2: 30kR 1%; SERVO-R2; MPN 0603WAF3002T5E; LCSC C22984
SERVO-R3: 12kR; SERVO-R3; MPN 0603WAF1202T5E; LCSC C22790
SERVO-U1: TPS54331DR; SERVO-U1; MPN TPS54331DR; LCSC C9865
USB-J1: 161N-4BVS11; USB-J1; MPN 161N-4BVS11; LCSC C5440752
USB-RCC1: 5.1kR; USB-RCC1; MPN 0603WAF5101T5E; LCSC C23186
USB-RCC2: 5.1kR; USB-RCC2; MPN 0603WAF5101T5E; LCSC C23186
USB-U2: H5VU25UC; USB-U2; MPN H5VU25UC; LCSC C20615800

Connections:
BAT: MOTOR1-C2.2, MOTOR1-C3.1, MOTOR1-C5.1, MOTOR1-U1.7 (VIN), MOTOR1-U1.13 (VIN), MOTOR1-U1.16 (VIN_LDO), MOTOR2-C2.2, MOTOR2-C3.1, MOTOR2-C5.1, MOTOR2-U1.7 (VIN), MOTOR2-U1.13 (VIN), MOTOR2-U1.16 (VIN_LDO), MOTOR3-C2.2, MOTOR3-C3.1, MOTOR3-C5.1, MOTOR3-U1.7 (VIN), MOTOR3-U1.13 (VIN), MOTOR3-U1.16 (VIN_LDO), MOTOR4-C2.2, MOTOR4-C3.1, MOTOR4-C5.1, MOTOR4-U1.7 (VIN), MOTOR4-U1.13 (VIN), MOTOR4-U1.16 (VIN_LDO), POWER-D1.2, POWER-J1.2 (_POS), SENSE-R1.1, SERVO-C1.1, SERVO-C2.1, SERVO-U1.2 (VIN)
BAT_ADC: ESP-U1.39 (IO1), SENSE-R1.2, SENSE-R2.1
ESP_BOOT: ESP-R2.2, ESP-SW2.1, ESP-U1.27 (IO0)
ESP_EN: ESP-C3.1, ESP-R1.2, ESP-SW1.1, ESP-U1.3 (EN)
ESP_USB_DM: ESP-R3.2, ESP-U1.13 (IO19)
ESP_USB_DP: ESP-R4.2, ESP-U1.14 (IO20)
GND: ESP-C1.2, ESP-C3.2, ESP-SW1.2, ESP-SW2.2, ESP-U1.1 (GND1), ESP-U1.40 (GND2), ESP-U1.41 (EP), IMU-C1.2, IMU-C2.2, IMU-U1.6 (GND), IMU-U1.7 (RESV1), MOTOR1-C3.2, MOTOR1-C5.2, MOTOR1-C6.2, MOTOR1-U1.8 (LSS), MOTOR1-U1.12 (LSS), MOTOR1-U1.15 (GND), MOTOR1-U1.25 (EP), MOTOR2-C3.2, MOTOR2-C5.2, MOTOR2-C6.2, MOTOR2-U1.8 (LSS), MOTOR2-U1.12 (LSS), MOTOR2-U1.15 (GND), MOTOR2-U1.25 (EP), MOTOR3-C3.2, MOTOR3-C5.2, MOTOR3-C6.2, MOTOR3-U1.8 (LSS), MOTOR3-U1.12 (LSS), MOTOR3-U1.15 (GND), MOTOR3-U1.25 (EP), MOTOR4-C3.2, MOTOR4-C5.2, MOTOR4-C6.2, MOTOR4-U1.8 (LSS), MOTOR4-U1.12 (LSS), MOTOR4-U1.15 (GND), MOTOR4-U1.25 (EP), MOTOR-R1.2, POWER-C1.2, POWER-C4.2, POWER-C5.2, POWER-C6.2, POWER-C7.2, POWER-C8.2, POWER-D3.2 (A), POWER-J1.1 (_NEG), POWER-R2.2, POWER-U1.7 (GND), SENSE-R2.2, SERVO-C1.2, SERVO-C2.2, SERVO-C5.2, SERVO-C6.2, SERVO-C7.2, SERVO-C9.2, SERVO-C10.2, SERVO-C11.2, SERVO-D1.2 (A), SERVO-J1.1, SERVO-J2.1, SERVO-R2.2, SERVO-U1.7 (GND), USB-J1.1 (EH2), USB-J1.2 (EH1), USB-J1.3 (EH4), USB-J1.4 (EH3), USB-J1.13 (A1B12), USB-J1.14 (B1A12), USB-RCC1.2, USB-RCC2.2, USB-U2.3 (GND), USB-U2.8 (GND); also elsewhere on the board
IMU_INT: ESP-U1.20 (IO12), IMU-U1.4 (INT1)
MOTOR1_A: MOTOR-J1.1 (A); also elsewhere on the board
MOTOR1_A_DRV: MOTOR1-U1.9 (SA); also elsewhere on the board
MOTOR1_B: MOTOR-J1.2 (B); also elsewhere on the board
MOTOR1_B_DRV: MOTOR1-U1.10 (SB); also elsewhere on the board
MOTOR1_C: MOTOR1-U1.11 (SC), MOTOR-J1.3 (C)
MOTOR1_IA: ESP-U1.38 (IO2); also elsewhere on the board
MOTOR1_IB: ESP-U1.15 (IO3); also elsewhere on the board
MOTOR1_PWM_A: ESP-U1.21 (IO13), MOTOR1-U1.4 (PWMA)
MOTOR1_PWM_B: ESP-U1.22 (IO14), MOTOR1-U1.5 (PWMB)
MOTOR1_PWM_C: ESP-U1.8 (IO15), MOTOR1-U1.6 (PWMC)
MOTOR1_V3P3: MOTOR1-C6.1, MOTOR1-U1.18 (V3P3)
MOTOR1_VCP: MOTOR1-C2.1, MOTOR1-U1.14 (VCP)
MOTOR2_A: MOTOR-J2.1 (A); also elsewhere on the board
MOTOR2_A_DRV: MOTOR2-U1.9 (SA); also elsewhere on the board
MOTOR2_B: MOTOR-J2.2 (B); also elsewhere on the board
MOTOR2_B_DRV: MOTOR2-U1.10 (SB); also elsewhere on the board
MOTOR2_C: MOTOR2-U1.11 (SC), MOTOR-J2.3 (C)
MOTOR2_IA: ESP-U1.4 (IO4); also elsewhere on the board
MOTOR2_IB: ESP-U1.5 (IO5); also elsewhere on the board
MOTOR2_PWM_A: ESP-U1.9 (IO16), MOTOR2-U1.4 (PWMA)
MOTOR2_PWM_B: ESP-U1.10 (IO17), MOTOR2-U1.5 (PWMB)
MOTOR2_PWM_C: ESP-U1.11 (IO18), MOTOR2-U1.6 (PWMC)
MOTOR2_V3P3: MOTOR2-C6.1, MOTOR2-U1.18 (V3P3)
MOTOR2_VCP: MOTOR2-C2.1, MOTOR2-U1.14 (VCP)
MOTOR3_A: MOTOR-J3.1 (C_1); also elsewhere on the board
MOTOR3_A_DRV: MOTOR3-U1.9 (SA); also elsewhere on the board
MOTOR3_B: MOTOR-J4.1 (C_1); also elsewhere on the board
MOTOR3_B_DRV: MOTOR3-U1.10 (SB); also elsewhere on the board
MOTOR3_C: MOTOR3-U1.11 (SC), MOTOR-J5.1 (C_1)
MOTOR3_IA: ESP-U1.6 (IO6); also elsewhere on the board
MOTOR3_IB: ESP-U1.7 (IO7); also elsewhere on the board
MOTOR3_PWM_A: ESP-U1.23 (IO21), MOTOR3-U1.4 (PWMA)
MOTOR3_PWM_B: ESP-U1.28 (IO35), MOTOR3-U1.5 (PWMB)
MOTOR3_PWM_C: ESP-U1.29 (IO36), MOTOR3-U1.6 (PWMC)
MOTOR3_V3P3: MOTOR3-C6.1, MOTOR3-U1.18 (V3P3)
MOTOR3_VCP: MOTOR3-C2.1, MOTOR3-U1.14 (VCP)
MOTOR4_A: MOTOR-J6.1 (C_1); also elsewhere on the board
MOTOR4_A_DRV: MOTOR4-U1.9 (SA); also elsewhere on the board
MOTOR4_B: MOTOR-J7.1 (C_1); also elsewhere on the board
MOTOR4_B_DRV: MOTOR4-U1.10 (SB); also elsewhere on the board
MOTOR4_C: MOTOR4-U1.11 (SC), MOTOR-J8.1 (C_1)
MOTOR4_IA: ESP-U1.12 (IO8); also elsewhere on the board
MOTOR4_IB: ESP-U1.17 (IO9); also elsewhere on the board
MOTOR4_PWM_A: ESP-U1.30 (IO37), MOTOR4-U1.4 (PWMA)
MOTOR4_PWM_B: ESP-U1.31 (IO38), MOTOR4-U1.5 (PWMB)
MOTOR4_PWM_C: ESP-U1.32 (IO39), MOTOR4-U1.6 (PWMC)
MOTOR4_V3P3: MOTOR4-C6.1, MOTOR4-U1.18 (V3P3)
MOTOR4_VCP: MOTOR4-C2.1, MOTOR4-U1.14 (VCP)
MOTOR_ENABLE: ESP-U1.24 (IO47), MOTOR1-U1.1 (ENA), MOTOR1-U1.2 (ENB), MOTOR1-U1.3 (ENC), MOTOR1-U1.24 (nSLEEP), MOTOR2-U1.1 (ENA), MOTOR2-U1.2 (ENB), MOTOR2-U1.3 (ENC), MOTOR2-U1.24 (nSLEEP), MOTOR3-U1.1 (ENA), MOTOR3-U1.2 (ENB), MOTOR3-U1.3 (ENC), MOTOR3-U1.24 (nSLEEP), MOTOR4-U1.1 (ENA), MOTOR4-U1.2 (ENB), MOTOR4-U1.3 (ENC), MOTOR4-U1.24 (nSLEEP), MOTOR-R1.1
MOTOR_FAULT: ESP-U1.36 (RXD0), MOTOR1-U1.20 (nFAULT), MOTOR2-U1.20 (nFAULT), MOTOR3-U1.20 (nFAULT), MOTOR4-U1.20 (nFAULT), MOTOR-R2.2
POWER_BST: POWER-C3.1, POWER-U1.1 (BOOT)
POWER_COMP: POWER-C7.1, POWER-R3.1, POWER-U1.6 (COMP)
POWER_COMP_ZERO: POWER-C6.1, POWER-R3.2
POWER_FB: POWER-R1.2, POWER-R2.1, POWER-U1.5 (VSENSE)
POWER_SS: POWER-C8.1, POWER-U1.4 (SS)
POWER_SW: POWER-C3.2, POWER-D3.1 (K), POWER-L1.1, POWER-U1.8 (PH)
SCL0: ENC-RC0.2, ESP-U1.19 (IO11), IMU-U1.13 (SCK)
SDA0: ENC-RD0.2, ESP-U1.18 (IO10), IMU-U1.14 (SDA)
SERVO1_PWM: ESP-U1.33 (IO40), SERVO-J1.3
SERVO2_PWM: ESP-U1.34 (IO41), SERVO-J2.3
SERVO_BOOT: SERVO-C8.1, SERVO-U1.1 (BOOT)
SERVO_COMP: SERVO-C9.1, SERVO-R3.1, SERVO-U1.6 (COMP)
SERVO_COMP_ZERO: SERVO-C10.1, SERVO-R3.2
SERVO_FB: SERVO-R1.2, SERVO-R2.1, SERVO-U1.5 (VSENSE)
SERVO_SS: SERVO-C11.1, SERVO-U1.4 (SS)
SERVO_SW: SERVO-C8.2, SERVO-D1.1 (K), SERVO-L1.1, SERVO-U1.8 (PH)
USB_CC1: USB-J1.6 (A5), USB-RCC1.1
USB_CC2: USB-J1.12 (B5), USB-RCC2.1
USB_DM: ESP-R3.1, USB-J1.7 (B7), USB-J1.9 (A7), USB-U2.2 (IO2)
USB_DP: ESP-R4.1, USB-J1.8 (A6), USB-J1.10 (B6), USB-U2.1 (IO1)
USB_VBUS: POWER-D2.2, USB-J1.15 (B4A9), USB-J1.16 (A4B9), USB-U2.4 (IO4)
V3_3: ENC-RC0.1, ENC-RD0.1, ESP-C1.1, ESP-R1.1, ESP-R2.1, ESP-U1.2 (VCC), IMU-C1.1, IMU-C2.1, IMU-U1.1 (SDO), IMU-U1.2 (MSDA), IMU-U1.3 (MCLK), IMU-U1.5 (VDDIO), IMU-U1.8 (VDD), IMU-U1.12 (SENB), MOTOR-R2.1, POWER-C4.1, POWER-C5.1, POWER-L1.2, POWER-R1.1; also elsewhere on the board
V5_SERVO: SERVO-C5.1, SERVO-C6.1, SERVO-C7.1, SERVO-J1.2, SERVO-J2.2, SERVO-L1.2, SERVO-R1.1
VIN: POWER-C1.1, POWER-D1.1, POWER-D2.1, POWER-U1.2 (VIN)

Notes on the sheet:
4s li-ion / lipo: 16.8 v maximum charged voltage
controller / esp32-s3
usb-c / programming and logic power
imu / tokmas variant
motor 2 / ss6343m
i2c address 0x37; use the tokmas register map
logic power / 3.3 v
motor 3 / ss6343m
motor 1 / ss6343m
gpio46 is input-only; motor enable defaults low
motor 4 / ss6343m
servo power / 5.07 v, 2 a
power entry, battery sensing and motor control
phase current sensing / four motors
