B44ken/ria/pcb/ria.kicad_pcb

## KiCad design pcb/ria.kicad_pcb (continued)

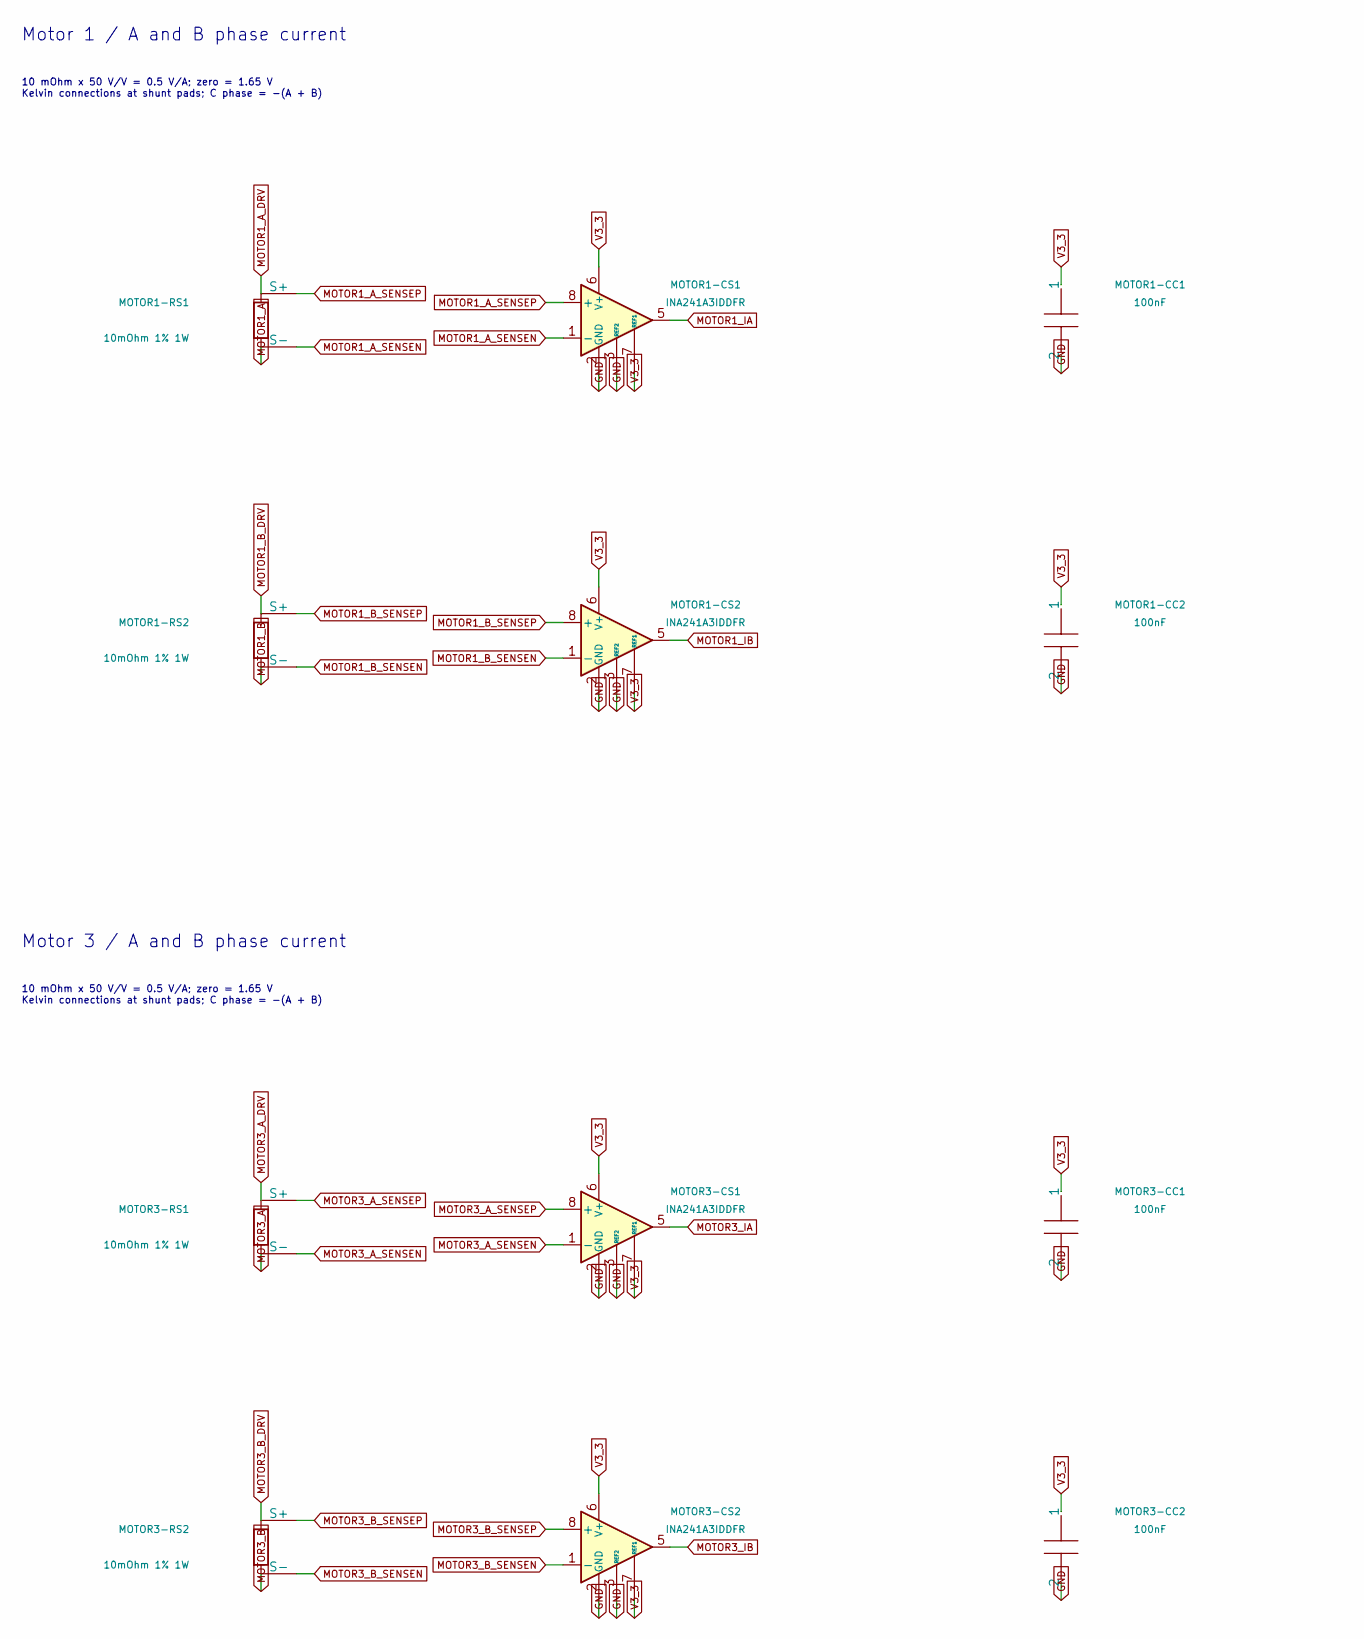
[picture p55: schematic ria-current.kicad_sch, ria / phase current sensing, part in row 1, column 1]

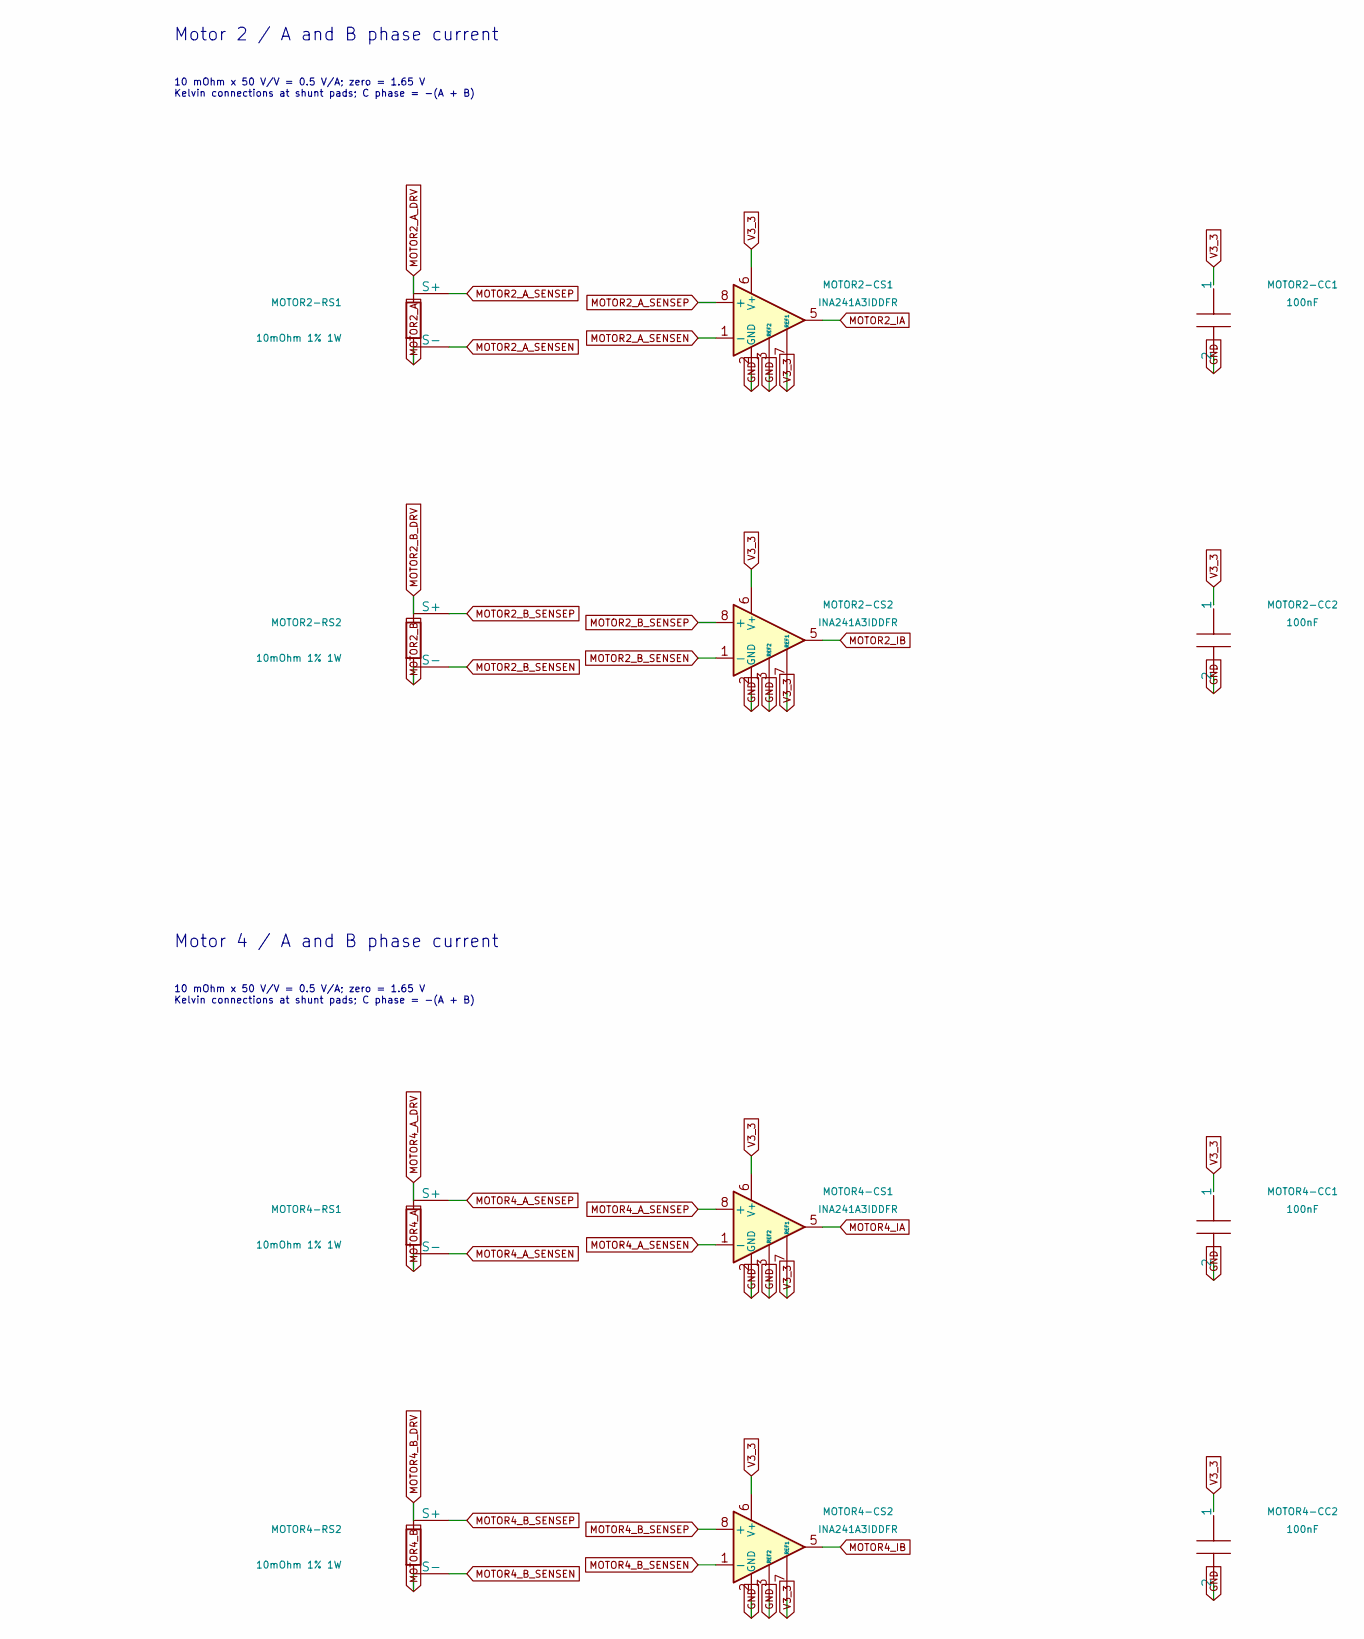
[picture p56: schematic ria-current.kicad_sch, ria / phase current sensing, part in row 1, column 2]

Parts:
MOTOR1-CC1, MOTOR1-CC2, MOTOR2-CC1, MOTOR2-CC2, MOTOR3-CC1, MOTOR3-CC2, MOTOR4-CC1, MOTOR4-CC2: 100nF; C_0603_CURRENT; MPN CC0603KRX7R9BB104; LCSC C14663
MOTOR1-CS1, MOTOR1-CS2, MOTOR2-CS1, MOTOR2-CS2, MOTOR3-CS1, MOTOR3-CS2, MOTOR4-CS1, MOTOR4-CS2: INA241A3IDDFR; INA241A3_DDF; MPN INA241A3IDDFR; LCSC C6051860
MOTOR1-RS1, MOTOR1-RS2, MOTOR2-RS1, MOTOR2-RS2, MOTOR3-RS1, MOTOR3-RS2, MOTOR4-RS1, MOTOR4-RS2: 10mOhm 1% 1W; SHUNT_1206_KELVIN; MPN SMR12M1FR010T; LCSC C2692042

Connections:
GND: MOTOR1-CC1.2, MOTOR1-CC2.2, MOTOR1-CS1.2 (GND), MOTOR1-CS1.3 (REF2), MOTOR1-CS1.4 (GND), MOTOR1-CS2.2 (GND), MOTOR1-CS2.3 (REF2), MOTOR1-CS2.4 (GND), MOTOR2-CC1.2, MOTOR2-CC2.2, MOTOR2-CS1.2 (GND), MOTOR2-CS1.3 (REF2), MOTOR2-CS1.4 (GND), MOTOR2-CS2.2 (GND), MOTOR2-CS2.3 (REF2), MOTOR2-CS2.4 (GND), MOTOR3-CC1.2, MOTOR3-CC2.2, MOTOR3-CS1.2 (GND), MOTOR3-CS1.3 (REF2), MOTOR3-CS1.4 (GND), MOTOR3-CS2.2 (GND), MOTOR3-CS2.3 (REF2), MOTOR3-CS2.4 (GND), MOTOR4-CC1.2, MOTOR4-CC2.2, MOTOR4-CS1.2 (GND), MOTOR4-CS1.3 (REF2), MOTOR4-CS1.4 (GND), MOTOR4-CS2.2 (GND), MOTOR4-CS2.3 (REF2), MOTOR4-CS2.4 (GND); also elsewhere on the board
MOTOR1_A: MOTOR1-RS1.2; also elsewhere on the board
MOTOR1_A_DRV: MOTOR1-RS1.1; also elsewhere on the board
MOTOR1_A_SENSEN: MOTOR1-CS1.1 (-), MOTOR1-RS1.4 (S-)
MOTOR1_A_SENSEP: MOTOR1-CS1.8 (+), MOTOR1-RS1.3 (S+)
MOTOR1_B: MOTOR1-RS2.2; also elsewhere on the board
MOTOR1_B_DRV: MOTOR1-RS2.1; also elsewhere on the board
MOTOR1_B_SENSEN: MOTOR1-CS2.1 (-), MOTOR1-RS2.4 (S-)
MOTOR1_B_SENSEP: MOTOR1-CS2.8 (+), MOTOR1-RS2.3 (S+)
MOTOR1_IA: MOTOR1-CS1.5; also elsewhere on the board
MOTOR1_IB: MOTOR1-CS2.5; also elsewhere on the board
MOTOR2_A: MOTOR2-RS1.2; also elsewhere on the board
MOTOR2_A_DRV: MOTOR2-RS1.1; also elsewhere on the board
MOTOR2_A_SENSEN: MOTOR2-CS1.1 (-), MOTOR2-RS1.4 (S-)
MOTOR2_A_SENSEP: MOTOR2-CS1.8 (+), MOTOR2-RS1.3 (S+)
MOTOR2_B: MOTOR2-RS2.2; also elsewhere on the board
MOTOR2_B_DRV: MOTOR2-RS2.1; also elsewhere on the board
MOTOR2_B_SENSEN: MOTOR2-CS2.1 (-), MOTOR2-RS2.4 (S-)
MOTOR2_B_SENSEP: MOTOR2-CS2.8 (+), MOTOR2-RS2.3 (S+)
MOTOR2_IA: MOTOR2-CS1.5; also elsewhere on the board
MOTOR2_IB: MOTOR2-CS2.5; also elsewhere on the board
MOTOR3_A: MOTOR3-RS1.2; also elsewhere on the board
MOTOR3_A_DRV: MOTOR3-RS1.1; also elsewhere on the board
MOTOR3_A_SENSEN: MOTOR3-CS1.1 (-), MOTOR3-RS1.4 (S-)
MOTOR3_A_SENSEP: MOTOR3-CS1.8 (+), MOTOR3-RS1.3 (S+)
MOTOR3_B: MOTOR3-RS2.2; also elsewhere on the board
MOTOR3_B_DRV: MOTOR3-RS2.1; also elsewhere on the board
MOTOR3_B_SENSEN: MOTOR3-CS2.1 (-), MOTOR3-RS2.4 (S-)
MOTOR3_B_SENSEP: MOTOR3-CS2.8 (+), MOTOR3-RS2.3 (S+)
MOTOR3_IA: MOTOR3-CS1.5; also elsewhere on the board
MOTOR3_IB: MOTOR3-CS2.5; also elsewhere on the board
MOTOR4_A: MOTOR4-RS1.2; also elsewhere on the board
MOTOR4_A_DRV: MOTOR4-RS1.1; also elsewhere on the board
MOTOR4_A_SENSEN: MOTOR4-CS1.1 (-), MOTOR4-RS1.4 (S-)
MOTOR4_A_SENSEP: MOTOR4-CS1.8 (+), MOTOR4-RS1.3 (S+)
MOTOR4_B: MOTOR4-RS2.2; also elsewhere on the board
MOTOR4_B_DRV: MOTOR4-RS2.1; also elsewhere on the board
MOTOR4_B_SENSEN: MOTOR4-CS2.1 (-), MOTOR4-RS2.4 (S-)
MOTOR4_B_SENSEP: MOTOR4-CS2.8 (+), MOTOR4-RS2.3 (S+)
MOTOR4_IA: MOTOR4-CS1.5; also elsewhere on the board
MOTOR4_IB: MOTOR4-CS2.5; also elsewhere on the board
V3_3: MOTOR1-CC1.1, MOTOR1-CC2.1, MOTOR1-CS1.6 (V+), MOTOR1-CS1.7 (REF1), MOTOR1-CS2.6 (V+), MOTOR1-CS2.7 (REF1), MOTOR2-CC1.1, MOTOR2-CC2.1, MOTOR2-CS1.6 (V+), MOTOR2-CS1.7 (REF1), MOTOR2-CS2.6 (V+), MOTOR2-CS2.7 (REF1), MOTOR3-CC1.1, MOTOR3-CC2.1, MOTOR3-CS1.6 (V+), MOTOR3-CS1.7 (REF1), MOTOR3-CS2.6 (V+), MOTOR3-CS2.7 (REF1), MOTOR4-CC1.1, MOTOR4-CC2.1, MOTOR4-CS1.6 (V+), MOTOR4-CS1.7 (REF1), MOTOR4-CS2.6 (V+), MOTOR4-CS2.7 (REF1); also elsewhere on the board

Notes on the sheet:
Motor 1 / A and B phase current
10 mOhm x 50 V/V = 0.5 V/A; zero = 1.65 V Kelvin connections at shunt pads; C phase = -(A + B)
Motor 2 / A and B phase current
Motor 3 / A and B phase current
Motor 4 / A and B phase current

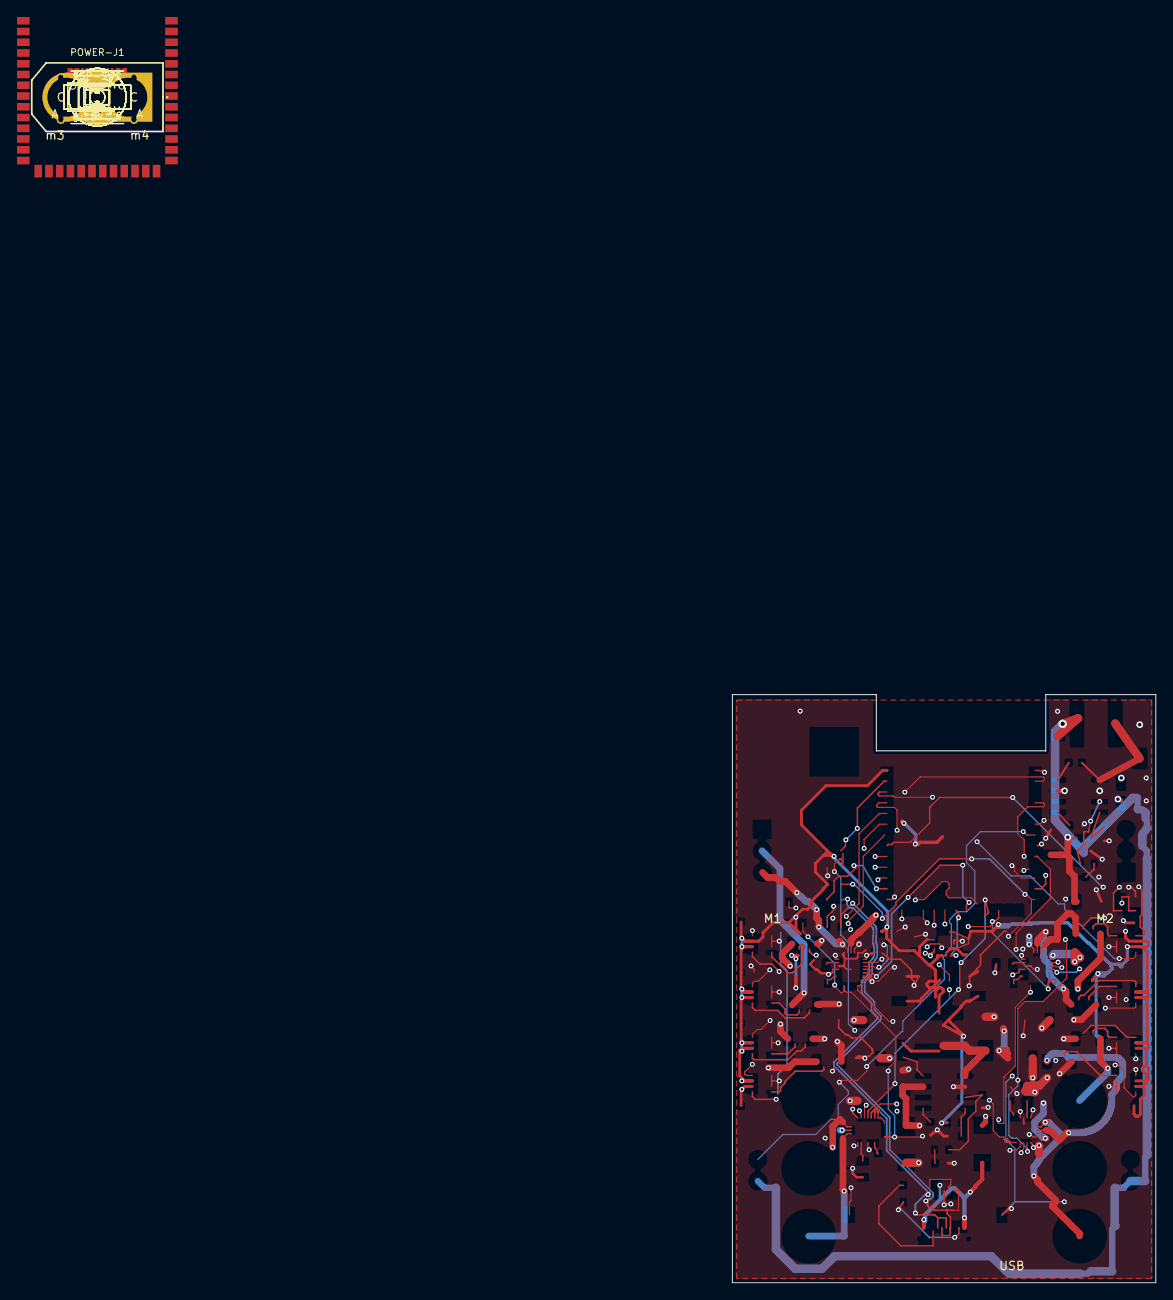
[picture p57: board ria.kicad_pcb from above]

Board: 4 copper layers, 50.0 x 69.5 mm, 107 parts (0 on the bottom side), 98 nets.
