B44ken/ria/(commit log)

2026-09-18 Document the ria CAD rewrite and reproducible build entry point
2026-09-18 Rewrite ria CAD around main.py; implement taut belt, screwless pulley and 18/12/42 knee
    Separate modelling, reference import, export, rendering, motion validation and regression.
    Preserve supplied hip/head geometry and original mating interfaces.
    Add 31 tests, STEP/GLB/STL round-trip checks and explicit physical-fit limitations.
2026-09-18 Check the preserved carrier mount beyond the intentionally resized disk
    Scope the mating-region regression to Y <= -26 mm, retaining both mounting holes.
    All 56 archived, 35 unchanged local, 72 installed and three interface checks pass.
    Add a direct old/new carrier-mount regression; 37 tests pass.
2026-09-18 Split the leg frame into flat-printing, dowel-located parts
    Replace the suspended monolith with hip link, knee backplate and ring prints.
    Add three M3x25 clamp screws and two 3x25 locating dowels per leg.
    Preserve 100 mm centres, gear teeth, axial stack and all 54 non-frame parts.
    Check exported STL layers, neutral interference, motion and driver access.
    Rebase onto the models/src reorganization and fix entry-point/test imports.
    51 tests pass; reopened STEP/GLB and all 19 STLs pass integrity checks.
2026-09-19 Make head and hip parametric; vendor checksum-verified motor CAD
    Build custom head, lid, hip mounts, bearing housings and pinion from dimensions.
    Vendor original 5010 rotor/stator and SG90 body/spline in mounting coordinates.
    Remove the normal-build dependency on the original archive and reference cache.
    Preserve the flat-print leg frame, default geometry and models/src layout.
    Update CLI, README, provenance and regression tests.
    All 75 tests pass. The complete 34-file source/assets tree matches the tested
    parametric bundle byte-for-byte. Motor CAD was verified on GitHub by SHA-256.
    Temporary binary-transport workflow is not included in this commit.
2026-09-19 latest iteration, complete-ish
    [pipico.step]
2026-09-28 sloppy first pcb via tscircuit + models updates
2026-09-28 clean up urdf stuff
    [ria.urdf]
2026-09-28 clean up urdf stuff, expose build files
    [5010_body_0.stl, 5010_rotor_1.stl, as5600_4.stl, as5600_5.stl, battery_shoe.stl, belt.stl, gbm2804_3.stl, head_bottom.stl]
2026-09-28 mock botblocks.json schema
    [ria.urdf]
2026-09-28 export robot meshes in their joint frames
    [as5600_5.stl, gbm2804_3.stl, lower_leg.stl, magnet_ankle.stl, planet_0.stl, planet_1.stl, planet_2.stl, wheel.stl]
2026-09-28 fix ria relative joints
2026-10-05 move to backplane pcb + software fixes
    [belt.stl, head_bottom.stl, head_top.stl, hip_follower.stl, lower_leg.stl, magnet_ankle.stl, magnet_knee.stl, pinion.stl]
2026-10-14 finish four-driver sensorless pcb and verify native design
2026-10-14 Add preserved October 5 RIA PCB candidate and audit sources
2026-10-14 value engineer capacitor sourcing and use available regulator
2026-10-14 remove obsolete pcb copies and generated documentation
2026-10-14 export current pcb fabrication files and complete assembly quote
2026-10-14 confirm assembly coupon and record unpaid checkout total
